Lobin0116/smart-glasses-charger/README.md

# smart-glasses-charger

AI Glasses Charging Case Firmware
