Lobin0116/smart-glasses-charger/CONTEXT.md

# Smart Glasses Charger — GD32E230C8T6 Firmware

## 项目背景

AI 眼镜充电盒固件，主控 GD32E230C8T6 (ARM Cortex-M23, LQFP48, 64KB Flash, 8KB SRAM)。
BLE 功能已移除，不实现任何蓝牙相关逻辑。

## 架构决策

- 运行模型: Bare-metal 超级循环 + 状态机（无 RTOS）
- 构建系统: CMake + arm-none-eabi-gcc（命令行构建）
- 外设库: GD32E23x 官方 Standard Peripheral Library V2.5.0
- 代码格式: clang-format 统一风格
- 交付: firmware/ 目录自包含，零 AI 痕迹

## 硬件平台

### MCU: GD32E230C8T6
- 12MHz 外部晶振 (PF0/PF1)
- 32.768K RTC晶振 (PC13/PC14/PC15)
- SWD调试: PA13(SWDIO) / PA14(SWCLK)

### 电源链路
- IP5353 (I2C_AABC): 移动电源SOC，Type-C PD/QC 18W输入，升压5V输出
- TPS563201: 12V降压
- RT9013-18: 1.8V LDO (PB10/1V8EN控制开关)
- 电池: 2000mAh 锂离子

### 无线充电
- MT5706: Qi2.0 EPP 15W (PB11/CHIP_EN2控制开关)

### I2C 总线 (PB6 SCL / PB7 SDA, I2C0, 200kHz)
- CW2017 电量计: 7-bit addr 0b1100011, 写=0xC6 读=0xC7
- IP5353: 控制寄存器 写=0xE8 读=0xE9, 状态寄存器 写=0xEA 读=0xEB

### POGO 通信链路
- ET3328 (SPDT模拟开关): POGO pin 5V充电 / 1.8V UART 切换
- BL1551B (U14): 半双工收发方向切换 (PB12/T/R_SWITCH)
- AiPTB0102TA8: 3.3V↔1.8V UART电平转换
- 物理层: 2-pin Pogo-Pin, UART 115200 8N1, 1.8V电平 (TIM 规格 921600，调试期偏离)

### ET3328 真值表 (MCU控制映射)
| 模式 | PB13(IN) | PB15(RPD) | PB10(1V8EN) | POGO状态 |
|---|---|---|---|---|
| 5V充电 | L | L | X | POGO↔CHG(5V) |
| 放电泄放 | X | H | H(1.8V on) | POGO放电 |
| 1.8V通信 | H | L | H(1.8V on) | POGO↔UART |

切换时序: 5V充电 → RPD=H放电100ms → IN=H切UART → 1V8EN=H开LDO → 通信

## 引脚分配表

| 引脚 | 信号 | 功能 | 外设 |
|---|---|---|---|
| PA0 | ADC_IN0 | 预留 | ADC |
| PA1 | ADC_IN1 | 预留 | ADC |
| PA2 | ADC_IN2 | 预留 | ADC |
| PA3 | ADC_IN3 | 预留 | ADC |
| PA4 | ADC_IN4 | 预留 | ADC |
| PA5 | ADC_IN5 | 预留 | ADC |
| PA6 | ADC_IN6 | 预留 | ADC |
| PA7 | ADC_IN7 | 预留 | ADC |
| PA8 | BAT_INT | 电量计中断 | GPIO输入(EXTI) |
| PA9 | CPU_TX | UART发送 | USART0_TX |
| PA10 | CPU_RX | UART接收 | USART0_RX |
| PA11 | CHAGER_INT | 有线充电中断 | GPIO输入(EXTI) |
| PA12 | COIL_INTB | 无线充电中断 | GPIO输入(EXTI) |
| PA13 | SWDIO | 调试 | SWD (禁占用) |
| PA14 | SWCLK | 调试 | SWD (禁占用) |
| PA15 | NC | 预留 | |
| PB0 | ADC_IN8 | 预留 | ADC |
| PB1 | ADC_IN9 | 预留 | ADC |
| PB2 | LED_2812 | WS2812数据 | GPIO输出 |
| PB3 | KEY | 按键(短按查电量) | GPIO输入(上拉) |
| PB4 | HALL_OUT_DIG | 霍尔磁场检测 | GPIO输入 |
| PB5 | NC | 预留 | |
| PB6 | SCL | I2C时钟 | I2C0_SCL (开漏) |
| PB7 | SDA | I2C数据 | I2C0_SDA (开漏) |
| PB8 | LEDR | 红色LED | GPIO输出 |
| PB9 | LEDG | 绿色LED | GPIO输出 |
| PB10 | 1V8EN | 1.8V LDO使能 | GPIO输出 |
| PB11 | CHIP_EN2 | 无线充电使能 | GPIO输出 |
| PB12 | T/R_SWITCH | 单线串口收发切换 | GPIO输出 |
| PB13 | POGO_IN | POGO通信使能(ET3328 IN) | GPIO输出 |
| PB14 | SHIP_CTR | 船运模式控制 | GPIO输出 |
| PB15 | RPD | POGO放电使能(ET3328 RPD) | GPIO输出 |
| PF0 | OSCIN | 12MHz晶振 | 固定保留 |
| PF1 | OSCOUT | 12MHz晶振 | 固定保留 |
| PF6 | LEDB | 蓝色LED | GPIO输出 |
| PF7 | LEDW | 白色LED | GPIO输出 |

## AT 通信协议

### 帧格式
Magic(4B) + CRC8(1B) + Size(2B) + Opcode(2B) + Status/Reserved(1B) + Payload(NB)
- 请求Magic: 0x23415423（小端线上字节 `23 54 41 23`）
- 响应Magic: 0x23415023（小端线上字节 `23 50 41 23`）
- CRC-8 使用协议文档提供的256字节查找表
- **CRC 覆盖范围（2026-09-04 真机修正）**：仅覆盖 **CRC 字节之后**的内容（Size/Opcode/Status/Payload），
  **不含 Magic**。协议 PDF 只给了查找表与 `at_crc8()` 函数、未写明覆盖范围；此前固件按"含 Magic"实现，
  与眼镜（MetaBounds 参考实现）互判 CRC 错误——真机握手死循环 `REQ → status=0x06 NAK`，HIL 未发现
  （PC 模拟器抄了固件同款算法）。真机抓包实证：眼镜 HEART RSP（0x25）与 NAK（0x52）按"不含 Magic"
  精确命中。修复见 main `99e1637` / V2 cherry-pick，`sgc_at.py` 同步（main `2f2fc7a`）。

**字节序（2026-08-14 统一）**：全部多字节字段（Magic/Size/Opcode 及 payload 内的 index/fw_size）统一**小端**；
`Size` 语义 = **payload 长度**（不含 10B 帧头），线上帧总长 = Size + 10。
此前实现为"帧头大端 + Size=总帧长 + OTA payload 小端"的混合格式，为对齐眼镜端协议（真机抓包确认
`23 54 41 23 · CRC · 04 00 · 01 30 · ...` 样式）已全量切换；PC 工具 sgc_at.py 同步。

### 指令集
| Opcode | 名称 | REQ Payload | RSP Payload |
|---|---|---|---|
| 0x3001 | 心跳包 | at_case_data | at_glass_data |
| 0x3002 | 关机/船运 | at_case_role | at_case_role |
| 0x3003 | 烧录准备 | at_case_role | at_case_packet_prepare |
| 0x3004 | 烧录数据 | at_case_packet_read | at_case_packet_transfer |

### 状态字段
- case_soc: bit7=1 充电中
- case_sta: bit0=开关盖(1开0关), bit7=申请OTA
- glass_soc: bit7=1 满电(0xE4=充满)
- glass_sta: bit7=1 同意

## 状态机设计

### 状态定义
- IDLE: 盖子关闭，无眼镜在盒，低功耗待机
- HANDSHAKING: 5V/300ms→0V/100ms泄放→1.8V发心跳(retry×3, 100ms间隔)
- CHARGING: 握手成功，供5V，30s(开盖)/60s(关盖)周期通信
- MAINTAINING: 握手成功但低电不充电，持续心跳维持入盒
- FORCE_CHARGING: 握手失败30s后，长供5V强充(3min/次, 持续9min)
- SHUTTING_DOWN: 充满/低电，发关机指令(retry×5)，然后休眠
- OTA: OTA传输流程
- SHIP_MODE: 船运模式

### 入盒检测机制
盒子发心跳 → 眼镜回复 = 入盒
盒子发心跳 → 无回复(retry 3次失败) = 不在盒/无法通信
眼镜端靠有无5V + 1.2s内心跳包维持或判断出盒

## 低功耗策略
- 正常休眠: Deep-Sleep，EXTI唤醒(霍尔/按键/CHAGER_INT/BAT_INT)，<50uA
- 船运模式: Standby + PB14(SHIP_CTR)外部控制，<5uA

## OTA 升级方案

布局（64KB flash @ 0x08000000, page = 1KB）：
- Bootloader: 0x08000000-0x08000FFF (4KB, page 0-3) — 永不擦，启动检查 + 搬运
- App slot A: 0x08001000-0x08007BFF (27KB, page 4-30) — 运行区
- Staging B: 0x08007C00-0x0800F7FF (31KB, page 31-61) — OTA 暂存区
- Meta: 0x0800F800 + 0x0800FC00 (page 62/63) — boot selector 双 page 轮换 (magic + staged + fw_size + seq + crc32)

流程：
1. App 收固件（眼镜推送，协议 0x3003/0x3004）→ 写 Staging B → 设 meta.staged → reset
2. BL 启动 → 读 meta → staged? → 擦 App pages + 复制 Staging→App + 清 staged → jump App
3. App 新版本运行

掉电安全：BL 永不擦自己，所有掉电场景都能恢复（Staging 完整时幂等搬运）。

关键约束：
- BL 跑 8MHz IRC（lite SystemInit 不配 PLL），搬运 ~3s
- BL 不开 WWDGT（reset 默认 off），App 自己 init
- BL jump App 前 `__enable_irq()`（App startup 不重新 enable）
- 单 image（眼镜推 App.bin 链接 ORIGIN=0x08001000），眼镜端零协议改动

构建产物：BL.hex + App.hex 合并为 combined.hex（`tools/merge_hex.py`），SWD 一次烧录。

详见 `docs/OTA_UPGRADE_PLAN.md`。

## LED 灯效规则
- 充电中(呼吸): 白(>40%) / 绿(15-40%) / 红(5-15%) / 红闪(1-5%)
- 充满: 白色长亮
- 查看电量(开盖/关盖): 对应颜色长亮7s灭
- 低电分级: >15%可充电可通信 / 5-15%可充电可通信 / 1-5%不可充电可开关 / <=0%关机

## IP5353 操作约束
- INT 持续为高 100ms 后才可读写 I2C 寄存器
- 修改寄存器需先读后改再写（read-modify-write），不可直接覆盖
- I2C 建议用 200kHz（最高 300kHz）

## NTC 温度保护分段阈值
- 0°C ~ <15°C: 0.2C / 4.45V
- 15°C ~ <45°C: 1.5C / 4.45V
- 45°C ~ 60°C: 0.5C / 4.1V
- 放电保护: -20°C ~ 60°C (TBD)

## 通信超时
- AT 协议请求→响应周期: **100ms**（spec，固件 OTA_TIMEOUT_MS=100）
- `at_frame_recv` 失败前清 buffer（避免 stale 干扰下次 retry）
- UART RX buffer: **512B**（容纳 2 个 OTA RSP，每个 255B；防止 HIL retry 时环形覆盖）

### OTA 稳定性历史（2026-08-12）
HIL 实测发现 OTA I02 在 100ms timeout 下 flaky。**根因不是 PC USB-TTL 抖动本身**，而是固件设计放大效应：
1. RX buffer 256B 装不下 2 个 RSP（510B），固件 retry 时 PC 第二个 RSP 环形覆盖第一个 → parse 失败 → 雪崩
2. at_frame_recv 失败时不清 buffer，stale 数据干扰下次 retry

**根本修复**：buffer 256B→512B + 失败前清 buffer。修复后 OTA_TIMEOUT_MS 保持 spec 100ms。

之前曾尝试 30ms timeout（实测有效但是治标），现已回退到 100ms。生产场景（眼镜 MCU 直连 POGO，<10ms 响应）不受影响。

## 低电阈值（待统一）
- 时序文档用电压: Vbat ≤ 3.4V = 低电
- 产品需求用 SOC%: ≤15% = 低电
- 3.4V 对应锂离子约 10-15% SOC，两文档不完全对齐
- 固件倾向以 CW2017 SOC% 为准，3.4V 作为后备判断

## LED 补充规则
- 眼镜&充电盒同时充满才显示白色
- 5min 无活动 → LED 关闭 → 进入休眠
- 低电关机前必须发 AT 关机指令给眼镜（适用所有低电休眠场景）

## 关键时序参数汇总
- 开盖/入盒握手: 5V/300ms → 0V/100ms泄放 → 1.8V心跳 retry×3(100ms间隔)
- 心跳维持入盒: <1.2s 间隔（眼镜端出盒检测超时）
- 开盖充电通信: 30s 周期
- 关盖充电通信: 60s 周期
- 强充: 30s握手失败后 → 长供5V, 3min/次, 持续9min
- 关机指令: retry×5, 无回复则认为已关机
- 充满后复充阈值: 眼镜电量 <98%
- LED电量显示: 长亮7s后灭

## 开发进度

状态: HIL 测试进行中（A 类协议测试 7/7 通过）
最新提交: HIL test hooks + USART RX DMA 通道修复 (2026-08-03)
Flash: 22056B / 64KB = 34.5%
RAM: 4424B / 8KB = 54.0%
源文件: 45 个 (.c + .h)
单元测试: 8 个，4 个测试套件，99 个 assertion，全部通过
HIL 测试: A 类协议 7/7 通过 (test_a_protocol.py，PC 模拟眼镜端)

| Task | 内容 | 状态 | Commit |
|---|---|---|---|
| 1 | 项目骨架 (SPL/CMSIS/CMake) | DONE | a91119f |
| 2 | HAL GPIO 初始化 | DONE | 95b7e67 |
| 3 | HAL USART0 (115200 半双工, DMA RX CH2 循环模式) | DONE | 0212d3c, 本次修复 |
| 4 | HAL I2C0 (200kHz) + 总线恢复 | DONE | c66cf7e, bfc1d2f |
| 5 | HAL EXTI (霍尔/按键/中断) | DONE | faa2f1c |
| 6 | HAL Timer (1ms tick) | DONE | 5c8c9b7 |
| 7 | HAL 电源切换 ET3328 | DONE | 41dacd3 |
| 8 | Driver CW2017 电量计 | DONE | 0e8eb9c |
| 9 | Driver IP5353 充放电 | DONE | d21b4e5 |
| 10 | Driver MT5706 无线充电 | DONE | a1cb320 |
| 11 | Driver LED | DONE | a1cb320 |
| 12 | Protocol at_types/at_crc | DONE | 55b184e |
| 13 | Protocol at_frame | DONE | 55b184e |
| 14 | Protocol at_opcode | DONE | 55b184e |
| 15 | App 状态机核心 | DONE | 6fcd38d |
| 16 | App 开盖流程 | DONE | 9359ef5 |
| 17 | App 关盖流程 | DONE | 9359ef5 |
| 18 | App OTA 流程 | DONE | daf3e2c |
| 19 | App LED 灯效 | DONE | 9359ef5 |
| 20 | App 低功耗管理 | DONE | de4249f |
| 21 | App 按键处理 | DONE | 9359ef5 |
| 22 | main.c 整合 | DONE | 89f93ae |
| 23 | 构建验证 | DONE | 89f93ae |
| 24 | App 眼镜入盒流程 | DONE | 9359ef5 |
| 25 | App NTC温度保护 | DONE | f36b374 |
| 26 | App 有线/无线充电仲裁 | DONE | f36b374 |
| 27 | App 复充逻辑 | DONE | f36b374 |
| 28 | App 开盖无眼镜分支 | DONE | 2ab35c7 |
| 29 | App LED并发优先级 | DONE | 9359ef5 |
| 30 | App 关盖无眼镜分支 | DONE | 2ab35c7 |
| 31 | 5min空闲超时 | CANCELLED (BLE相关) | |
| 32 | HAL 看门狗 IWDG | DONE | 6fcd38d |

集成修复历史:
- NTC温度保护/充电仲裁/复充/OTA调用/低电关机 — f36b374
- 关盖事件/无眼镜显示/Deep-Sleep/SOC刷新/按键动作 — 2ab35c7
- ISR竞争修复 (g_led_ctx deferred to main loop) — 6cc6574
- Deep-Sleep EXTI pending清除 + I2C总线恢复 — bfc1d2f
- USART RX DMA 通道修复 (CH1→CH2, 原 TX/RX 通道搞反) + 循环模式 ring buffer + update_mode peek (保留心跳响应字节不被命令解析消费) — 本次提交
- HIL 测试钩子 (sm_inject_lid_event / update_mode_poll OPEN/CLOSE/KEY/RESET) — 本次提交

测试套件:
| Suite | Assertions | 覆盖范围 |
|---|---|---|
| gpio_config | 24 | 引脚初始化/AF编号/LED电平/按键电平/使能控制 |
| protocol | 18 | CRC8/帧组装/帧解析/Magic校验/坏CRC拒绝/roundtrip |
| charge_flow | 38 | case_soc/sta字节构建/NTC分区/复充判断/充电仲裁 |
| state_machine | 19 | 全部状态转换路径/握手成功失败/低电关机/shutdown retry |

## 已知限制 (Known Limitations)

1. 阻塞调用: charge_flow 中握手序列阻塞约 800ms (5V 300ms + 泄放 100ms + retry 3×100ms)
   - 期间 LED 呼吸冻结、按键无响应
   - 看门狗超时 2s，不触发复位
   - 这是文档要求的物理时序，不可缩短
   - 如需消除卡顿可将 charge_flow 改为非阻塞状态机（代码量约翻倍）

2. OTA 阻塞: ota_run() 同步执行，期间主循环停滞
   - 内部每个 exchange 循环喂看门狗，不会复位
   - 传输时间取决于固件大小（921600 baud）

3. Deep-Sleep 时钟: SysTick 在 Deep-Sleep 期间停止
   - 唤醒后 hal_timer_get_ms() 时间不连续
   - 当前架构只在 ST_IDLE 时 sleep，握手/充电不经过 IDLE，不影响

## 待确认项 (Pending)

1. ~~LED方案: WS2812(PB2) vs 4路GPIO LED(PB8/PB9/PF6/PF7)~~
   - 已确认: 使用 4路 GPIO LED, 低电平点亮 (active-low)
   - WS2812(PB2) 不使用, hal 层 on/off 函数已按 active-low 实现

2. ~~A-SP1924RBGWW datasheet~~
   - 已确认: 输出低电平点亮 LED

## HIL 测试进展 (Hardware-in-the-Loop)

测试环境: GD32E230 核心板 + USB-TTL (PA9/PA10) + PC pytest 模拟眼镜端
测试矩阵: docs/HIL_TEST_MATRIX.md (9 类 ~70 用例)

最新 baseline (2026-08-12): 19 PASS / 1 XPASS / 2 flaky-PASS (A15/F03) / 1 FAIL (I01 retry-limit) / 3 skip / I02 偶发 PASS

| 类别 | 内容 | 状态 | 备注 |
|---|---|---|---|
| A | AT 协议帧格式 (Magic/Size/Opcode/CRC/Payload) | ✅ PASS 9/9 (含 A15 重写为 MAINTAINING 验证) | 2026-08-12；⚠ 2026-08-14 切换全小端+Size=payload长 后**未重跑**（用户指示），期望字节断言需更新 |
| B | 时序 (握手 800ms / 心跳间隔 / 30s 开盖 / 60s 关盖 / 9min 强充) | ✅ PASS B03/B04 | 2026-08-12 |
| C | 状态机转换全覆盖 | ✅ PASS C01/C02, C07 XPASS (xfail 标记可去) | C03/C12 skip（CW2017 profile 烧录后解锁，待硬件验证） |
| E | 按键 (短按查电量 / 50ms 去抖 / 长按忽略) | ✅ PASS E01 | 2026-08-12 |
| F | 霍尔 (双沿注入 / 开关盖转换) | ✅ PASS F01/F02/F03 (F02/F03 flaky 标记) | HIL 命令注入时序竞争 |
| G | LED 灯效 (呼吸颜色 / 充满白 / 查电量 7s / 低电红闪) | ❌ TODO | 需人眼观察或自动化 |
| H | 充电仲裁 (USB 优先 / 无线 fallback / NTC 停充) | ❌ TODO | — |
| I | OTA 升级 | ✅ PASS I01+I02（2026-08-14，全小端新协议下首测：I01 8s / I02 20.7s，烧录后心跳帧与眼镜真机抓包格式逐字节一致） | 旧大端时代的 flaky 已随 512B RX buffer + clear-on-failure 根治 |
| J | 低功耗 (Deep-Sleep <50uA / Standby <5uA / 唤醒源) | ❌ TODO | 需电流计 |

### I 类 OTA 已知问题（HIL 测试工具限制，非固件 bug）

**现象**：I02 完整 OTA 烧录过程中，固件 at_frame_recv 偶发 timeout (100-500ms)，
导致固件 retry，PC 端 [ota] 时序显示 `recv=213-1018ms`（正常 16ms）。
单次 rerun 烧录完成率约 70-90%，flaky reruns 后能 PASS。

**根因**（逻辑分析仪 + PC 详细时间戳定位）：
- PC pyserial write 函数本身快（w_call=11ms）
- PC flush 立刻完成（flush=0ms）
- **但 PC write 返回后到 PA10 实际输出字节之间偶尔延迟 200ms+**
- 延迟来自 Windows USB 调度 / USB-TTL 模块（CH340 等）内部缓冲
- 固件 at_frame_recv timeout 期间没收到 RSP，触发 retry

**关键结论**：**固件无 bug**。生产场景眼镜端 MCU 实时响应（< 10ms），
没有 USB-TTL 中间环节，不会出现此问题。

**已应用的缓解**：
- 固件 at_frame_recv 三个 wait 循环加 hal_wwdgt_feed（防 WDT 复位）
- at_frame_recv 成功消费后 hal_usart_rx_clear（清 stale 帧）
- OTA_TIMEOUT_MS=100ms, RETRIES=5（500ms 容错）
- ota_run fail_reason 诊断码 (10-18) + post-status fixture
- I01/I02 标 @pytest.mark.flaky(reruns=3)
- _enter_charging 改用 STATUS 验证（不依赖心跳间隔）

**未应用的进一步缓解**（如果 HIL 稳定性仍不够）：
1. PC 端关闭后台进程（VSCode/浏览器），任务管理器设 python.exe 优先级=高
2. 设备管理器 → USB Root Hub → 电源管理 → 取消"允许计算机关闭此设备以节约电源"
3. USB-TTL 直接接主板 USB 口（不通过 HUB）
4. 换 FTDI USB-TTL 模块（比 CH340 稳定）或 PCIe 串口卡（绕过 USB）
5. 固件 OTA_EXCHANGE_RETRIES 5 → 30（容错 3s，覆盖大部分抖动）

## 待硬件验证 (Hardware Verification Required)

以下功能已在软件层面实现和单元测试，但未在实际硬件上验证：

### 已通过 HIL 验证
- ✅ UART 实际通信 — POGO 心跳帧收发（A 类 9/9，2026-08-12）
- ✅ AT 协议帧格式（Magic/Size/Opcode/CRC/Payload）
- ✅ OTA 触发链路（I01：OTA 命令 → bit7 申请 → 同意 → PREPARE）
- ✅ OTA 完整烧录链路（I02 偶发 PASS：推 108 块 → BL 搬运 → 新版本运行 → 版本验证）
- ✅ 状态机基础转换（C01/C02/C07）
- ✅ 时序（B03 retry 间隔, B04 100ms 超时）
- ✅ 按键 + 霍尔（E01/F01/F02/F03）

### 待硬件验证（HIL 自动化）
1. **B 类时序** — 其余时序用例（30s/60s/9min 长周期）
2. **C 类状态机** — C03/C12 等 SOC 依赖 case（待 CW2017 profile 烧录后解锁）
3. **E 类按键** — 50ms 去抖 / 长按忽略（物理按键测试）
4. **F 类霍尔** — 物理磁铁触发（HIL 用命令注入已验证状态机逻辑）
5. **G 类 LED** — 呼吸效果 / 充满白长亮 / 查电量 7s / 低电红闪（G 类需人眼或光传感器自动化）
6. **H 类充电仲裁** — USB 插入切无线 / 拔 USB 切无线 / NTC critical 停充
7. **J 类低功耗** — Deep-Sleep <50uA / Standby <5uA / EXTI 唤醒源（HALL/KEY/CHAGER/BAT）

### 待硬件验证（非 HIL 自动化，需仪器/真机）
1. **I2C 实际通信** — CW2017/IP5353 寄存器读写（部分通过 SCAN 命令间接验证）
2. **电源时序** — ET3328 5V/0V/1.8V 切换波形（示波器抓 RPD/IN/1V8EN）
3. **充电全流程** — 开盖→握手→充电→充满→关机（真机 + 眼镜）
4. **OTA 与真眼镜端互通** — 协议一致性 + 实际升级成功率

### 已知硬件问题（阻塞部分测试）
- **~~CW2017 battery profile 未烧录~~**：**已在固件层实现 auto-burn**（cw2017.c：`cw2017_init` 启动时检查 MODE_CONFIG/SOC_ALERT/PROFILE，必要时自动烧录 80 字节 profile（⚠ Cellwise demo 默认的 4.2V 曲线，产品规格未定义截止电压，非电池厂数据）+ 触发 quickstart）。首次启动 ~250ms 烧录，后续启动 ~10ms 自检跳过。烧录后 VERSION=0xA0、SOC=0-100% 应正常，解锁 C03/C05/C12 等 SOC 依赖 case。**待硬件实测确认**（板子重新烧固件后自动生效）。

## 待完成 (Code/Documentation)

代码层尚未实现或待核对的项，按优先级排序：

| 项 | 说明 | 优先级 |
|---|---|---|
| SHIP_MODE 进入路径 | **待确认**：状态枚举 `ST_SHIP_MODE` 存在，`pm_enter_ship_mode()` 实现了（power_mgmt.c:32 → Standby + 拉高 PB14 SHIP_CTR），但代码无任何路径调用 → 当前是死代码。REQ §"运输功能"说"眼镜厂内设置进入船运模式"，但**进入触发机制不明**（工厂夹具？长按？HIL 命令？）。**决策暂缓**：暂留代码不动，待产品/工程确认进入方式后再删除死枚举或加触发路径 | 待确认 |
| ~~LED 低电红闪 7s（BATTERY_DISPLAY 低电分支）~~ | **已修复**：REQ §3 "1%<SOC≤5% 红闪 7s" 是查电量场景（不是持续低电闪）。`apply_effect(BATTERY_DISPLAY)` 低电分支改 LED_BLINK；`resolve_effect` 删 case_soc≤5% 自动闪路径；删 `LED_EFFECT_LOW_BATT_BLINK` 枚举。HIL 时人眼验证 | ✅ Done |
| ~~单元测试补 hal_bootmeta~~ | **已完成**：`firmware/tests/test_bootmeta.c` 12 用例 / 58 assertion 全通过。覆盖 pick_latest（空/m0/m1/双 seq 比较）+ meta_validate（bad magic/CRC）+ 双 page 轮换（set/clear 交替）+ 掉电恢复（一页 CRC 损坏时回退另一页）+ OTA round-trip。改动：hal_bootmeta.c 改用 `hal_flash_read` 取代直接 dereference（产代码 memory-mapped memcpy），让 host 测试可 mock；hal_flash.h/.c 加 `hal_flash_read` | ✅ Done |
| ~~SOC 异常兜底校验~~ + ~~CW2017 profile 烧录~~ | **已修复**：cw2017.c 启动时 auto-burn 80 字节 profile（⚠ Cellwise demo 默认 4.2V 曲线，未经电池规格证实），quickstart 后 SOC 应正常。`cw2017_get_soc` 保留 SOC==0/>100 fallback=100 兜底（防芯片异常）。C03/C05/C12 待硬件实测确认解锁 | ✅ Done |
| CW2017 profile 烧录工具 | 不需要独立工具：固件 cw2017_init 自检 + auto-burn 已实现，无需 HIL 命令/USB-I2C 适配器 | ✅ Done |
| 波特率发布前确认 | 当前 115200（调试期偏离 spec 921600），发布前与眼镜端对齐 | 发布前 |
| ota_verify 空函数 | 协议（PROT/TIM）无 checksum 字段，OTA_UPGRADE_PLAN §6 明确预留 | 低（协议扩展后补） |
| 5min 无活动 LED 关闭 | BLE 相关，已 CANCELLED（CONTEXT.md 已记录） | 取消 |

## ⚠️ 临时测试代码（HIL_TEST 编译开关隔离）

为兼顾"成品代码完整性"和"HIL 测试自动化"，所有测试钩子用 `HIL_TEST` CMake option + `#ifdef HIL_TEST` 编译开关隔离。**一份源码，两种构建**，无需手动还原代码。

### 构建方式

| 构建 | 命令 | 产物 | 用途 |
|---|---|---|---|
| **生产**（默认） | `cmake -S firmware -B build` | `build/smart_glasses_charger.hex` (21260B) | 成品固件，Deep-Sleep 生效，无测试接口 |
| **HIL 测试** | `cmake -DHIL_TEST=ON -S firmware -B build_hil` | `build_hil/smart_glasses_charger.hex` (25724B) + `build_hil/bootloader.hex` (2560B) + `combined.hex` (BL+App 合并) | 启用测试钩子，PC 自动驱动状态机 |

### 测试钩子清单（均由 `HIL_TEST` 宏控制）

| 钩子 | 位置 | HIL_TEST=ON 时 | HIL_TEST=OFF 时（生产） |
|---|---|---|---|
| ST_IDLE 保持唤醒 | `state_machine.c` `case ST_IDLE:` | `break;`（不 sleep） | `pm_enter_deep_sleep(); break;` |
| `sm_inject_lid_event` | `state_machine.c` + `.h` | 编译（供 OPEN/CLOSE 调用） | `#ifdef` 排除，不存在 |
| `update_mode` 模块 | `update_mode.c`（整文件）+ `.h` | 编译，提供 OPEN/CLOSE/KEY/RESET/STATUS/SCAN/I2C/OTA 命令（UPDATE 已删，OTA 替代） | `#ifdef` 排除，整文件为空 |
| `sm` 可见性 | `main.c` | `sm_ctx_t sm;`（非 static，供 update_mode extern） | `static sm_ctx_t sm;`（封装） |
| 主循环轮询 | `main.c` `while(1)` 开头 | 调用 `update_mode_poll()` | 不调用 |

### 设计原则

- **成品代码路径在 `#else` 分支清晰可见**：读代码即可看到生产行为（例如 `state_machine.c` 的 `case ST_IDLE:` 同时展示两种分支）
- **生产构建不包含测试代码**：`--gc-sections` + `#ifdef` 双保险，update_mode 模块在生产 hex 中完全不存在
- **无需手动还原**：切换构建配置即可，不会遗漏
- **测试 hex 与生产 hex 体积不同**（差 ~800B），便于区分

### 生产发布检查

- [ ] 发布 hex 来自 `build/`（HIL_TEST=OFF），不是 `build_hil/`
- [ ] `arm-none-eabi-size build/smart_glasses_charger.elf` 应为 ~21260B text（生产大小）
