Lobin0116/smart-glasses-charger/docs/spec/functional_analysis.docx

## 一、电源充放电核心链路（英集芯 IP5353）

### 核心芯片：IP5353 移动电源一体化 SOC

1. 输入路径（Type-C 充电盒自充）Type-C 接口先经过OVP/OCP 过压过流保护（耐压 28V，防高压插拔损坏），输出 3~4A/5V 给 IP5353。
  1. 支持 PD3.0/QC/FCP/AFC 全快充协议，最大 18W 输入给内置 2000mAh 锂电池充电，电池充电电流最高 4A，适配大电流快充。
  2. INT中断引脚直连 ATB1119G 主控，上报充电盒充放电状态。
2. 输出路径（给 AI 眼镜充电）IP5353 升压输出 5V，经过FT3328 模拟开关后给到 2-Pogo PIN 磁吸触点：
  1. 单线半双工通讯机制：当 VBUS_OUT 电压＞3.85V 时，供电与数据复用，实现充电同时读取眼镜电量、固件交互；
  2. TX/RX 串口直连 ATB1119G，完成眼镜与充电盒主控的数据互通。
3. 电池管理2000mAh 锂电池直接挂载 IP5353 电池端，内置过充 / 过放 / 过流 / 过温保护，大电流充放电自带散热控制。

## 二、无线充电支路（美芯晟 MT5706/MT5708）

- 功能：外部无线底座给充电盒无线补电，兼容 Qi2.0 EPP 15W 标准；
- 控制逻辑：线圈感应电压输入 MT5706，芯片EN使能脚由 ATB1119G 主控控制，可软件开关无线充电功能；
- 数据交互：MT5706 通过 I2C 总线上报无线充电功率、异常状态至 ATB1119G；
- 选型区分：MT5706 标准 15W，MT5708 高功率 36W，本方案穿戴设备优先 MT5706。

## 三、主控核心：ATB1119G（炬芯 BLE5.3 MCU）

### 芯片定位：整机大脑，集成蓝牙 5.3 低功耗 MCU

1. 核心能力
  - 超低功耗架构：BLE 待机电流仅 6μA，休眠 nA 级，满足充电盒 30 天以上静置待机；
  - 丰富外设：I2C、UART、多路 GPIO/PWM，统筹所有外设；
  - 蓝牙 5.3 BLE：与手机 APP 通讯，上报充电盒电量、眼镜电量、开盖状态。
2. 总线与外设对接
  - I2C 总线 1：对接库仑计 CW2217，读取电池精准剩余电量 SOC；
  - I2C 总线 2：对接无线充 MT5706，读取无线充电状态；
  - UART (TX/RX)：对接 FT3328 模拟开关，和 AI 眼镜单线通讯；
  - IO 控制 IP5353 使能、霍尔开盖检测；
  - PWM 驱动四色 RGBW 指示灯，显示充电 / 配对 / 低电状态；
  - GPIO 读取物理配对按键。

## 四、外设功能模块拆解

### 1. 电量检测：CW2217 高精度库仑计

赛微微电低功耗电量计，通过 I2C 上传电池电压、充放电电流、剩余电量百分比，相比单纯电压采样，电量误差＜3%，手机 APP 可精准显示剩余续航。

### 2. 开盖检测：SC2033 单极霍尔开关

盒盖内置磁铁，开盖 / 合盖时磁场变化触发 IO 电平变化，ATB1119G 识别后执行对应逻辑：

- 开盖：点亮指示灯、蓝牙广播连接手机、自动读取眼镜电量；
- 合盖：延时关闭指示灯、降低蓝牙发射功率，进入低功耗休眠。

### 3. 眼镜通讯：FT3328 模拟开关

实现充电供电 + 单线数据复用，5V 供电线路叠加半双工通讯信号，无需额外触点即可和 AI 眼镜交互固件、电量、设备配对信息。

### 4. 交互外设

- RGBW 四色 LED：PWM 驱动，多色区分状态（红 = 低电、橙 = 充电、绿 = 满电、蓝 = 蓝牙配对）；
- 物理按键：GPIO 输入，长按 3s 触发蓝牙配对，短按查询电量灯光提示。

## 五、整机工作流程梳理

1. 外部有线充电：Type-C 输入→OVP 保护→IP5353 给电池充电→ATB1119G 实时读取电量，LED 提示充电进度；
2. 外部无线充电：无线线圈→MT5706 接收→IP5353 给电池充电，主控同步监控无线功率；
3. 给 AI 眼镜充电：放入眼镜触发磁吸导通→IP5353 升压 5V→FT3328 输出至 Pogo PIN，同时单线读取眼镜数据；
4. 蓝牙交互：ATB1119G 通过 BLE5.3 连接手机 APP，同步充电盒 / 眼镜电量、开盖记录、固件升级；
5. 休眠节能：合盖后霍尔开关触发，主控降低蓝牙功耗，关闭 LED，整机进入微安级低功耗待机。

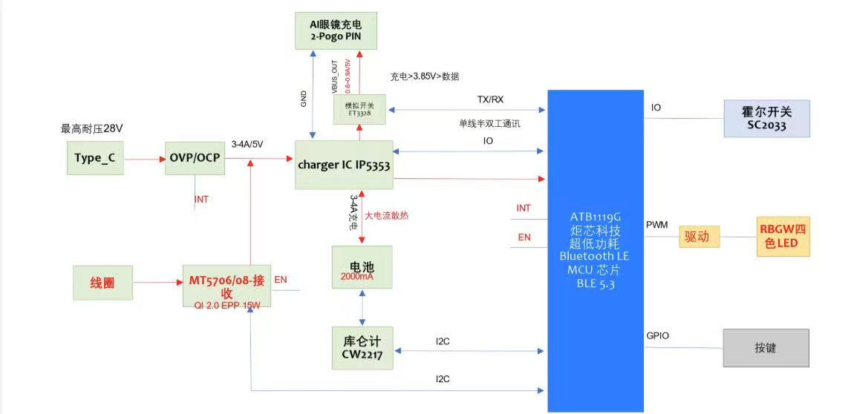
[picture p1: figure]
ddd81046b117e5e644b48d2da0b7e750
