Lobin0116/smart-glasses-charger/docs/spec/dual_pin_timing_v0.1.xlsx

Sheet: 首页
波特率：921600 校验位：无 数据位：8 停止位：1 通讯电平：1.8V，一个指令发送和等待回码共占时100ms
修改记录
日期 |  | 修改
2026-06-27 |  | 双pin机盒通信时序初版
Pin定义
Vbus/Uart |  | GND
5V切Vbus充电，1.8V切Uart 通信
机盒通讯指令
心跳包 |  |  |  |  |  |  |  |  |  |  |  | typedef struct { at_case_role role; // @see at_case_role_e uint8_t case_soc; uint8_t case_sta; } at_case_data; typedef struct { at_case_role role; // @see at_case_role_e uint8_t glass_soc; uint8_t glass_sta; uint8_t case_version; } at_glass_data;
请求帧 | MAGIC （4 Byte） | CRC （1 Byte） | SIZE (2 Byte) | OPCODE (2 Byte) | RESERVED (1 Byte) | PAYLOAD (N Byte)
 |  |  |  |  |  | at_case_data
 | 0x23415423 | crc |  | 0x3001 | 0x00 | 接收端（1 byte）： | 发送端（1 byte）： | 盒子电量（1byte）: 最高位为1表示充电 | 盒子状态（1byte）: bit0表示开关盖状态，1开盖，0关盖； bit7，1表示申请进入盒子ota； | NA
响应帧 | MAGIC （4 Byte） | CRC （1 Byte） | SIZE (2 Byte) | OPCODE (2 Byte) | STATUS (1 Byte) |  | PAYLOAD (N Byte)
 |  |  |  |  |  | at_glass_data
 | 0x23415023 | crc |  | 0x3001 | 0x00 | 接收端（1 byte）： | 发送端（1 byte）： | 眼镜电量（1byte）：最高位表示充满了，满电为0xE4; | 眼镜状态（1byte）： bit7:1 表示同意，0表示不同意 | 盒子固件版本（1byte）
关机/船运
请求帧 | MAGIC （4 Byte） | CRC （1 Byte） | SIZE (2 Byte) | OPCODE (2 Byte) | RESERVED (1 Byte) | PAYLOAD (N Byte)
 | 0x23415423 | crc |  | 0x3002 | 0x00 | 接收端（1 byte）： | 发送端（1 byte）：
响应帧 | MAGIC （4 Byte） | CRC （1 Byte） | SIZE (2 Byte) | OPCODE (2 Byte) | STATUS (1 Byte) | PAYLOAD (N Byte)
 | 0x23415023 | crc |  | 0x3002 | 0x00 | 接收端（1 byte）： | 发送端（1 byte）：
烧录准备(prepare) |  |  |  |  |  |  |  |  |  |  | typedef struct { at_case_role role; // @see at_case_role_e uint32_t size; } at_case_packet_prepare;
请求帧 | MAGIC （4 Byte） | CRC （1 Byte） | SIZE (2 Byte) | OPCODE (2 Byte) | RESERVED (1 Byte) | PAYLOAD (N Byte)
 |  |  |  |  |  | at_case_role
 | 0x23415423 | crc |  | 0x3003 | 0x00 | 接收端（1 byte）： | 发送端（1 byte）：
响应帧 | MAGIC （4 Byte） | CRC （1 Byte） | SIZE (2 Byte) | OPCODE (2 Byte) | STATUS (1 Byte) | PAYLOAD (N Byte)
 |  |  |  |  |  | at_case_packet_prepare
 | 0x23415023 | crc |  | 0x3003 | 0x00 | 接收端（1 byte）： | 发送端（1 byte）： | sizie：固件大小
烧录(read) |  |  |  |  |  |  |  |  |  |  | typedef struct { at_case_role role; // @see at_case_role uint16_t index; // 包序号 uint16_t size; // 包大小 } at_case_packet_read; typedef struct { at_case_role role; // @see at_case_role uint16_t index; // 包序号 uint8_t type; // @see at_packet_type_e uint8_t data[]; } at_case_packet_transfer;
请求帧 | MAGIC （4 Byte） | CRC （1 Byte） | SIZE (2 Byte) | OPCODE (2 Byte) | RESERVED (1 Byte) | PAYLOAD (N Byte)
 |  |  |  |  |  | at_case_packet_read
 | 0x23415423 | crc |  | 0x3004 | 0x00 | 接收端（1 byte）： | 发送端（1 byte）： | index：发包的计数 size
响应帧 | MAGIC （4 Byte） | CRC （1 Byte） | SIZE (2 Byte) | OPCODE (2 Byte) | STATUS (1 Byte) | PAYLOAD (N Byte)
 |  |  |  |  |  | at_case_packet_transfer
 | 0x23415023 | crc |  | 0x3004 | 0x00 | 接收端（1 byte）： | 发送端（1 byte）： | index； type； data；
眼镜端逻辑
出入盒 | 1.收到心跳包识别为入盒； 2.没有5v的时候进行1.2s出盒检测； 3.收到心跳包刷新1.2s出盒检测； 4.盒子ota过程中需要维持入盒状态；

Sheet: 开盖处理流程
1.开盖处理流程（盒子电量充足，包含盒子在充电）
1.1、开盖后输出5v 300ms让眼镜开机，再输出0v 100ms泄放，再切到1.8v 发心跳包；心跳包握手失败需retry 3次，每次间隔100ms；
1.2、心跳包里告知眼镜开关盖状态，同时获取到眼镜的电量及充电状态；
1.3、握手成功后，进入开盒充电，盒子供5v，每30s和眼镜通讯一次，通信时注意加100ms的泄放，收到眼镜充满后，不需要给眼镜发关机；// 这里眼镜端要注意双pin场景充电ic可能不会报截至
1.4、握手成功，眼镜充满后，盒子可不供5v，切1.8v通信，并不断给眼镜发心跳包（1.2s）内来维持眼镜的在盒状态，当眼镜电量低于98%的时候复充（需要显示电量的逻辑）； 或者可以继续按充电的逻辑保持5v，30s（可修改）通信一次，这样眼镜端可以维持在盒状态；
1.5、握手失败（retry 3次），继续 1.1 的操作，持续30s； 30s后，进入强充逻辑（考虑眼镜亏电的场景），长供5v，3分钟通信一次，持续9分钟； 强充之后如果眼镜依然没有回复，盒子进入休眠；如果眼镜正常回复走握手成功流程；
5V |  | 开盖波形 |  |  |  |  |  |  |  |  |  |  |  | 待完善
 |  | 5V
1.8V |  |  |  |  |  |  |  | 循环1 |  |  | 循环2
 |  |  |  | 心跳包 | 心跳包回复 |  |  | 心跳包 | 心跳包回复 |  | 心跳包 | 心跳包回复
GND
 |  |  | 500ms |  |  |  | 30s |  |  |  | 60s
 | 开盖握手成功
5V |  | 开盖波形 |  |  |  |  |  |  |  |  |  |  |  |  |  | 待完善
 |  | 5V
1.8V |  |  |  | 循环1（10s） |  |  |  |  | 循环2（3分钟）
 |  |  |  | 心跳包 |  | 心跳包 |  |  | 心跳包 |  |  | 心跳包
GND
 |  |  | 500ms |  | 间隔100ms |  | 间隔10s |  |  | 间隔10s |  |  |  | 盒子进入休眠
 | 开盖握手失败
2.开盖处理流程（盒子低电）
1.1、开盖后输出5v 300ms让眼镜开机，再输出0v 100ms泄放，再切到1.8v 发心跳包；心跳包握手失败需retry 3次，每次间隔100ms；
1.2、心跳包里告知眼镜开关盖状态，同时获取到眼镜的电量及充电状态；
1.3、握手成功后，不给眼镜充电，持续发心跳包（1.2s以内）以保持眼镜的在盒状态，直到盒子进入低电关机或休眠；
1.4、握手失败（retry 3次），直接进入休眠； // 失败直接进修改，按眼镜当前开机需要10~20s才能通信上的情况，低电开盖大概率都会走这里； 可以先这样，低电盒子开盖能激活眼镜就好了；
5V |  | 开盖波形 |  |  |  |  |  |  |  |  |  |  |  |  | 待完善
 |  | 5V
1.8V |  |  |  |  |  |  |  | 循环1 |  |  | 循环2
 |  |  |  | 心跳包 | 心跳包回复 |  |  | 心跳包 | 心跳包回复 |  | 心跳包 | 心跳包回复
GND |  |  |  |  |  |  |  |  |  |  |  |  | 盒子触发低电休眠
 |  |  | 500ms |  |  | 间隔10s |  |  |  | 间隔10s
 | 开盖握手成功
5V |  | 开盖波形 |  |  |  |  |  |  |  |  |  |  |  |  | 待完善
 |  | 5V
1.8V
 |  |  |  | 心跳包 |  | 心跳包 |  | 心跳包
GND
 |  |  | 500ms |  | retry 3次 |  |  |  | 盒子进入休眠
 | 开盖握手失败

Sheet: 开盒充电处理流程
1.盒子低电且不在充电，眼镜入盒
1.1、盒子检测眼镜入盒，具体方式由盒子端决定；
1.2、盒子检测到眼镜入盒，供5v 300ms让眼镜开机，再输出0v 100ms泄放，再切到1.8v 发心跳包； // 这里供5v300ms主要考虑到眼镜可能关机了，但是基本不会出现这个情况，后面具体情况具体分析
1.3、握手成功，不给眼镜充电，持续发心跳包（1.2s以内）以保持眼镜的在盒状态，直到盒子进入低电关机或休眠；
1.4、握手失败（retry 3次），直接进入休眠；// 这里可能需要持续，如果眼镜关机了，开机后需要10~20s才能通信上
5V |  | 眼镜入盒波形 |  |  |  |  |  |  |  |  |  |  |  |  | 待完善
 |  | 5V
1.8V |  |  |  |  |  |  |  | 循环1 |  |  | 循环2
 |  |  |  | 心跳包 | 心跳包回复 |  |  | 心跳包 | 心跳包回复 |  | 心跳包 | 心跳包回复
GND |  |  |  |  |  |  |  |  |  |  |  |  | 盒子触发低电休眠
 |  |  | 500ms |  |  | 间隔10s |  |  |  | 间隔10s
 | 眼镜入盒握手成功
5V |  | 眼镜入盒波形 |  |  |  |  |  |  |  |  |  |  |  |  | 待完善
 |  | 5V
1.8V
 |  |  |  | 心跳包 |  | 心跳包 |  | 心跳包
GND
 |  |  | 500ms |  | retry 3次 |  |  |  | 盒子进入休眠
 | 眼镜入盒握手失败
2.盒子电量充足（包含盒子在充电的场景），眼镜入盒
2.1、盒子检测眼镜入盒，具体方式由盒子端决定；
2.2、盒子检测到眼镜入盒，供5v 300ms让眼镜开机，再输出0v 100ms泄放，再切到1.8v 发心跳包；
2.3、握手成功后，进入开盒充电，盒子供5v，每30s和眼镜通讯一次，通信时注意加100ms的泄放，收到眼镜充满后，不需要给眼镜发关机；
2.4、握手失败（retry 3次），继续 2.2 的操作，持续30s； 30s后，进入强充逻辑（考虑眼镜亏电的场景），长供5v，3分钟通信一次，持续9分钟； 强充之后如果眼镜依然没有回复，盒子进入休眠；如果眼镜正常回复走握手成功流程；
5V |  | 眼镜入盒波形 |  |  |  |  |  |  |  |  |  |  |  | 待完善
 |  | 5V
1.8V |  |  |  |  |  |  |  | 循环1 |  |  | 循环2
 |  |  |  | 心跳包 | 心跳包回复 |  |  | 心跳包 | 心跳包回复 |  | 心跳包 | 心跳包回复
GND
 |  |  | 500ms |  |  |  | 30s |  |  |  | 60s
 | 眼镜入盒握手成功
5V |  | 眼镜入盒波形 |  |  |  |  |  |  |  |  |  |  |  |  |  | 待完善
 |  | 5V
1.8V |  |  |  | 循环1（10s） |  |  |  |  | 循环2（3分钟）
 |  |  |  | 心跳包 |  | 心跳包 |  |  | 心跳包 |  |  | 心跳包
GND
 |  |  | 500ms |  | 间隔100ms |  | 间隔10s |  |  | 间隔10s |  |  |  | 盒子进入休眠
 | 眼镜入盒握手失败

Sheet: 关盖处理流程
1.关盖处理流程(眼镜在盒，电池电压大于 3.4V(根据盒子实际情况))
1.1、盒子检测眼镜入盒，具体方式由盒子端决定；
1.2、盒子检测到眼镜入盒，供5v 300ms，再输出0v 100ms 泄放，再切到1.8v 发心跳包，走眼镜入盒充电流程；
1.3、盒子关盖，立刻发心跳包更新状态；
1.4、握手成功，进入关盒充电，每60s和眼镜通讯一次，收到眼镜充满信息后，给眼镜发关机指令（这里可以通过多次发关机指令来确认眼镜是否关机），然后进入休眠；
1.5、握手失败（retry 3次），进入强充逻辑（考虑眼镜亏电的场景），长供5v，3分钟通信一次，持续9分钟； 强充之后如果眼镜依然没有回复，盒子进入休眠；如果眼镜正常回复走关盒充电流程；
待完善
5V |  | 盒子关盖波形
 |  | 5V
1.8V |  |  |  |  |  |  |  | 循环1 |  |  | 循环2 |  |  | 收到眼镜充满标志位 |  |  | 发5次，当眼镜没有回复时认为眼镜已经关机，盒子进行休眠；5次后，盒子进入休眠；
 |  |  |  | 心跳包 | 心跳包回复 |  |  | 心跳包 | 心跳包回复 |  | 心跳包 | 心跳包回复 |  | 心跳包 | 心跳包回复 |  | 关机/船运 | 回复 | 关机/船运 | 回复 | 关机/船运
GND
 |  | 开盖状态 | 盒子关盖 |  |  |  | 进入关盖充电 |  |  |  | 心跳包间隔60s |  |  |  |  | 掉5v | 发关机/船运指令 |  |  |  | 盒子进入休眠
 | 盒子关盖握手成功
待完善
5V |  | 盒子关盖波形
 |  | 5V
1.8V |  |  |  |  |  |  |  | 循环2（3分钟）
 |  |  |  | 心跳包 | 心跳包 | 心跳包 |  | 心跳包 |  |  | 心跳包
GND
 |  | 开盖状态 | 盒子关盖 |  | retry 3次，间隔100ms |  |  | 间隔10s |  |  |  |  | 盒子进入休眠
 | 盒子关盖握手失败
2.关盖处理流程(电池电压小于等于 3.4V(根据盒子实际情况))
2.1、盒子检测眼镜入盒，具体方式由盒子端决定；
2.2、盒子检测到眼镜入盒，供5v 300ms，再输出0v 100ms 泄放，再切到1.8v 发心跳包，走眼镜入盒充电流程；
2.3、盒子关盖，立刻发心跳包更新状态；
2.4、握手成功，给眼镜发关机指令，然后进入休眠；
2.5、握手失败（retry 3次），直接进入休眠；
待完善
5V |  | 盒子关盖波形
 |  | 5V
1.8V |  |  |  |  |  |  | 发5次，当眼镜没有回复时认为眼镜已经关机，盒子进行休眠；5次后，盒子进入休眠；
 |  |  |  | 心跳包 | 心跳包回复 |  | 关机/船运 | 回复 |  | 关机/船运 | 回复 |  | 关机/船运
GND
 |  | 盒子低电关5v | 盒子关盖 |  |  |  |  |  |  |  |  |  | 盒子进入休眠
 | 盒子关盖握手成功
待完善
5V |  | 盒子关盖波形
 |  | 5V
1.8V
 |  |  |  | 心跳包 |  | 心跳包 |  | 心跳包
GND
 |  | 盒子低电关5v | 盒子关盖 |  | 间隔100ms |  |  | 盒子进入休眠
 | 盒子关盖握手成功

Sheet: 盒子ota流程
文字描述： 1.盒子申请进入ota，眼镜同意； 2.盒子发prepare指令，眼镜回复size； 3.盒子发read指令，包含包大小/index，眼镜端回复data/index/type； 4.直到烧录完成，盒子发心跳包清ota标志位（bit7），退出ota模式；
