Lobin0116/smart-glasses-charger/docs/spec/product_requirement_v0.1.xlsx

Sheet: 版本
版本号： Version NO. |  | V0.1
产品经理 Product Manager |  | 王贵明 |  |  | Date: | 2026.05.15
版本批准： Approval |  |  |  |  | Date:
修改记录Revision
版本号Version | Date | Name | Reason | Modifications Made |  | Changed
V 0.1 | 2026.05.15 | 王贵明 | 建档 | 初版

Sheet: 整机规格参数
产品规格描述
H/W | 细项 | Requirement | 备注
处理器
电池（Battery） | 类型 | 锂离子电池
 | 容量（mAh） | 2000mAh（TBD） | Target 6~8 times charging (TBD, need cost and ME design to refer)
 | 输入电流 | 2C充电 | 外界对眼镜盒充电
 | 输出电流 | 900mA MAX | 眼镜盒对眼镜充电
 | 典型给眼镜充电时间 | 80%电量，30min
无线充电 | 功率 | 15W
NTC | 充电保护 | 0℃ - <15℃：0.2C/4.45V 15℃ - < 45℃：1.5C/4.45V 45℃ - 60℃: 0.5C/4.1V | 分段保护(TBD)
 | 放电保护 | -20℃ - 60℃:XXC | TBD
传感器 (Sensor) | 霍尔传感器 | ✔YES □NO | 盒盖开合
 | 其他 | □YES ✔NO
按 键 （Keypad） | 功能键 | □YES ✔NO | 一个
接口 (I/O) | 眼镜盒充自身充电接口 | USB-C PD | 给充电盒充电
 | 眼镜充电接口 | 2-pin Pogo-Pin | 眼镜盒对眼镜充电
 | 其他接口 | □YES ✔NO
指示灯 | 指示灯 | ✔YES □NO | RGB灯一个
结 构（Mechanical） | 铰链 | 折叠设计
 | 三防功能 | / | 按键+type-c接口需要做防水设计 TBD
认证（Certification） | 船运模式 | ✔YES □ NO
 | 认证需求 | SRRC、FCC、CEC、CE、MIC、KIC、CCC | 中国、美国、日本、韩国、欧洲、中国台湾、泰国、新加坡、英国、阿联酋（以认证清单为准，和眼镜对齐）

Sheet: 眼镜盒交互定义
充电盒指示灯显示
Function Item | 触发条件 | 前置操作 | 指示灯状态 | 备注
1.外部电源对充电盒充电 | 1.插入USB | 充电盒未充电 | 1.充电盒电量＞40%，充电盒白色指示灯呼吸 2.15%≤盒电量≤40%：充电盒绿色指示灯呼吸 3.5%＜盒子电量≤15%，充电盒红色指示灯呼吸 4.1%＜盒子电量≤5%，充电盒红色指示灯呼吸 5、充满电，白色指示灯长亮。 | 1. 插入充电线，同时给充电盒和眼镜充电 2. 充电过程中，有其他动作切入，优先显示切入动作的灯效，后恢复充电灯效 3. 眼镜&充电盒同时充满才显示白色 | 仅供参考，实际UX有待客户明确
2.充电盒给眼镜充电 | 眼镜放入充电盒 |  | 1. 充电中，充电盒眼镜/对应指示灯呼吸（各级电量颜色） 2. 充满电，充电盒眼镜/对应指示灯亮7s（各级电量颜色），然后灭。 | 1. 充电盒电量低于5%，充电盒不给眼镜充电 2. 低电关机之前，发码给眼镜关机。
3.充电盒电量查看 | 1. 开盖或者关盖 | 充电盒未充电 | 1.充电盒电量＞40%，充电盒白色指示灯长亮7s，灭 2.15%≤盒电量≤40%：充电盒绿色指示灯长亮7s，灭 3.5%＜盒子电量≤15%，充电盒红色指示灯长亮7s，灭 4.1%＜盒子电量≤5%，红色灯闪烁7秒
4、低电状态说明 |  |  | 1. 盒子电量>15% ，对眼镜可充电可通信 2. 5%＜盒子电量≤15%，对眼镜可充电可通信 3. 1%＜盒子电量≤5%，不可充电，可以开关眼镜 4. 盒子电量≤0% 盒子，关机
Function Item | 触发条件 | 触发状态 | 指示灯状态 | 语音状态
2.运输功能 | 1. 眼镜厂内设置进入船运模式，超低功耗； 2. 取出眼镜，按(电源)键激活眼镜，激活后自动进入配对状态 3. 放入充电盒内. 对眼镜充电（即关盖-开盖一次），激活眼镜，激活后自动进入配对状态 | 运输模式 | N/A | N/A
充电盒开关盖功能 |  | 关盖：、眼镜关机；开盖：、眼镜开机
Function Item |  | 触发条件 | 前置操作 | 触发状态 | 备注
1. 开盒动作事件触发机制 | 1.1 无眼镜，盒子外指示灯显示盒子电量 | 打开充电盒盖 | 充电盒关闭 | 充电盒指示灯仅显示充电盒电量 | 1.充电盒电量＞40%，充电盒白色指示灯长亮7s，灭 2.15%≤盒电量≤40%：充电盒绿色指示灯长亮7s，灭 3.5%＜盒子电量≤15%，充电盒红色指示灯长亮7s，灭 4.1%＜盒子电量≤5%，红色灯闪烁7秒
 | 1.2 有眼镜，首次开盖（无连接记录） |  |  | 充电盒指示灯仅显示充电盒电量；7s 7s之后判断状态； 1、进入配对状态，白色每秒闪烁2次； 2、若眼镜/5min无连接，指示灯关闭； | 1.充电盒电量＞40%，充电盒白色指示灯长亮7s，灭 2.15%≤盒电量≤40%：充电盒绿色指示灯长亮7s，灭 3.5%＜盒子电量≤15%，充电盒红色指示灯长亮7s，灭 4.1%＜盒子电量≤5%，红色灯闪烁7秒
 | 1.3 有眼镜，有连接记录的情况下进入回连模式； |  |  | 充电盒指示灯仅显示充电盒电量；7s 7s之后判断状态； 1、如果15s后回连手机失败，进入配对状态，白色每秒闪烁2次； 2、若5min无连接眼镜/进入休眠，指示灯关闭； | 1.充电盒电量＞40%，充电盒白色指示灯长亮7s，灭 2.15%≤盒电量≤40%：充电盒绿色指示灯长亮7s，灭 3.5%＜盒子电量≤15%，充电盒红色指示灯长亮7s，灭 4.1%＜盒子电量≤5%，红色灯闪烁7秒
 | 1.4 有眼镜，长按充电盒功能键，按键时间=>8秒，重置眼镜（恢复出厂设置），眼镜进入配对模式； |  |  | 进入配对模式：充电盒白色指示灯1s闪2次； 连接成功（已连接模式）：指示灯白色长亮7s，熄灭； 若5min无连接眼镜/进入休眠，指示灯关闭；
Function Item |  | 触发条件 | 前置操作 | 触发状态 | 备注
2. 关盒动作事件触发机制 | 2.1 无眼/ | 关闭充电盒盖 | 充电盒开启 | 关闭充电盒盖，指示灯显示充电盒电量 | 1.充电盒电量＞40%，充电盒白色指示灯长亮7s，灭 2.15%≤盒电量≤40%：充电盒绿色指示灯长亮7s，灭 3.5%＜盒子电量≤15%，充电盒红色指示灯长亮7s，灭 4.1%＜盒子电量≤5%，红色灯闪烁7秒
 | 2.2 有眼镜 |  |  | 1、充电中，指示灯呼吸（颜色根据充电盒电量）。 2、充满电，指示灯长亮7s后灭 | 1.充电盒电量＞40%，充电盒白色 2.15%≤盒电量≤40%：充电盒绿色 3.盒子电量≤15%，充电盒红色
 | 眼镜连接APP，支持APP 显示眼镜盒电量指示
