Lobin0116/smart-glasses-charger/docs/spec/AT_Communication_Protocol.pdf

# AT 眼镜盒通信协议

## 1. 协议设计

## 1.1 帧格式

## AT 眼镜盒通信协议

[备注]

密级 | 内部公开

## 修订历史

版本 | 修订者 | 日期 | 备注
1.0 | 周泽煌 | 2026-01-21 | 初稿
1.1 | 戴杰 | 2026-03-21 | 增加机盒心跳/关机/ 盒子ota相关指令
1.2 | 戴杰 | 2026-03-26 | 调整ota相关指令逻 辑

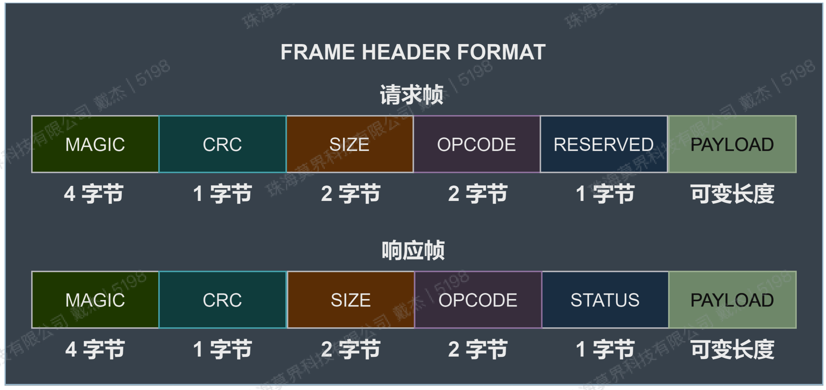
[picture p2: figure]

图 3-1 数据帧格式

### 2.1 字段说明

### 2.2 数据格式

字段 | 含义 | 长度 | 值 | 说明
Magic | 魔数 | 4 Bytes | 0x23415423 | 请求码（#AT#）
| | | 0x23415023 | 响应码（#AP#）
Crc | 校验码 | 1 Bytes | 0x00 ~ 0xFF | CRC-8校验码
Size | 负载大小 | 2 Bytes | 0x0000 ~ 0xFFFF
Opcode | 操作码 | 2 Bytes | 0x0000 ~ 0xFFFF | 指令 ID
Reserved | 保留字段 | 1 Bytes | 0x00 | 保留字段
Status | 状态码 | 1 Bytes | 0x00 | 成功
| | | 其它 | 失败
Payload | 数据负载 | 可变长度 | | 前两个字节用来区分数据流 向 参考at_case_role定义

## 2.2.1 Payload定义

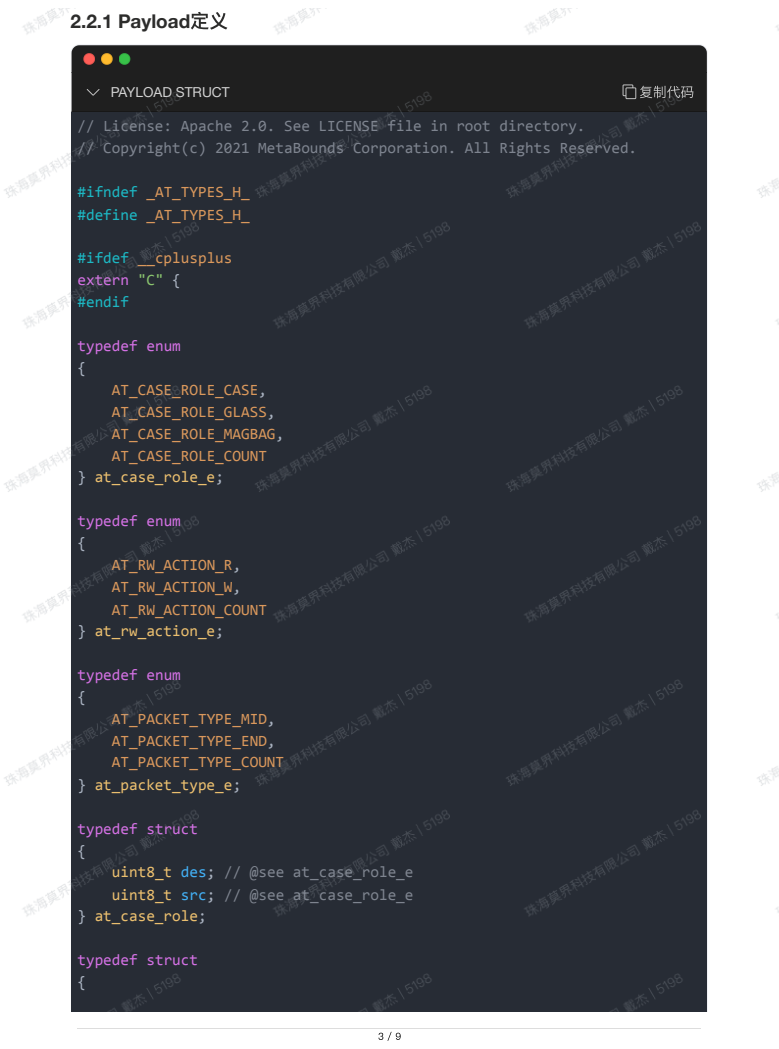
[picture p3: page 3]
PAYLOAD STRUCT; 复制代码; #ifndef _AT_TYPES_H_ #define _AT_TYPES_H_; #ifdef __cplusplus extern "C" { #endif; typedef enum {; AT_CASE_ROLE_CASE, AT_CASE_ROLE_GLASS, AT_CASE_ROLE_MAGBAG, AT_CASE_ROLE_COUNT } at_case_role_e;; AT_RW_ACTION_R, AT_RW_ACTION_W, AT_RW_ACTION_COUNT } at_rw_action_e;; AT_PACKET_TYPE_MID, AT_PACKET_TYPE_END, AT_PACKET_TYPE_COUNT } at_packet_type_e;; typedef struct {; uint8_t des; // @see at_case_role_e uint8_t src; // @see at_case_role_e } at_case_role;

// License: Apache 2.0. See LICENSE file in root directory.
// Copyright(c) 2021 MetaBounds Corporation. All Rights Reserved.

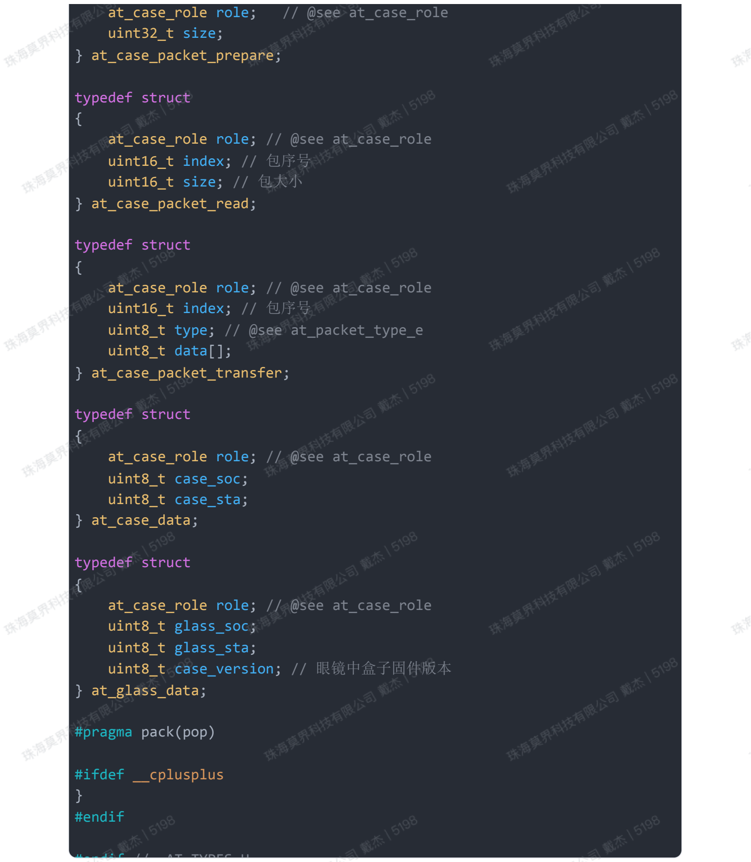
[picture p4: figure]
at_case_role role;; // @see at_case_role; uint32_t size; } at_case_packet_prepare;; typedef struct {; at_case_role role; // @see at_case_role uint16_t index; // 包序号 uint16_t size; // 包大小; } at_case_packet_read;; at_case_role role; // @see at_case_role uint16_t index; // 包序号; uint8_t type; // @see at_packet_type_e uint8_t data[]; } at_case_packet_transfer;; at_case_role role; // @see at_case_role uint8_t case_soc; uint8_t case_sta; } at_case_data;; at_case_role role; // @see at_case_role uint8_t glass_soc; uint8_t glass_sta; uint8_t case_version; // 眼镜中盒子固件版本; } at_glass_data;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

## 2.2.2 状态码

状态码枚举 | 复制代码

## typedef enum

{
AT_SUCCESS | = 0x00, // 成功
AT_ERR_IO | = 0x01, // IO 错误
AT_ERR_TIMEOUT | = 0x02, // 超时
AT_ERR_LENGTH | = 0x03, // 长度错误
AT_ERR_PARAMS | = 0x04, // 非法参数
AT_ERR_RESULT | = 0x05, // 测试失败
AT_ERR_CRC | = 0x06, // 校验错误
AT_ERR_CHANNEL | = 0x07, // 通道错误
AT_ERR_HARDWARE | = 0x08, // 硬件错误
AT_ERR_UNSUPPORT | = 0x09, // 不支持
AT_ERR_RUNTIME_MODE | = 0x0A, // 运行模式错误

## AT_ERR_DATA_NOT_READY = 0xFC, // 包不完整或不足以解析

AT_ERR_NULL | = 0xFD, // 空指针
AT_ERR_MAGIC | = 0xFE, // 魔数错误
AT_ERR_UNKNOEN | = 0xFF, // 未知错误
} at_status;
状态码 | 值 | 说明
AT_SUCCESS | 0x00 | 操作成功
AT_ERR_IO | 0x01 | IO 错误
AT_ERR_TIMEOUT | 0x02 | 响应、或执行超时
AT_ERR_LENGTH | 0x03 | 长度错误
AT_ERR_PARAMS | 0x04 | 非法参数
AT_ERR_RESULT | 0x05 | 指令执行失败
AT_ERR_CRC | 0x06 | CRC 校验错误
AT_ERR_CHANNEL | 0x07 | 通道传输错误
AT_ERR_HARDWARE | 0x08 | 硬件错误

## 2.3 指令集

## 2. 指令格式

# 3. CRC校验

at_crc.h | 复制代码

AT_ERR_UNSUPPORTED | 0xFE | 不支持
AT_ERR_UNKNOWN | 0xFF | 未知错误
操作码 | 值 | 说明
... | 0x3000 | ...
AT_OPCODE_CASE_HEART | 0x3001 | 机盒通信心跳
AT_OPCODE_CASE_SHUTDOWN | 0x3002 | 关机
AT_OPCODE_CASE_PACKET_PREPAR E | 0x3003 | 传输固件准备
AT_OPCODE_CASE_PACKET_READ | 0x3004 | 传输固件

#ifndef __AT_METAGLASS_CRC_H__ #define __AT_METAGLASS_CRC_H__

#include "mo_stdint.h"

#ifdef __cplusplus

extern "C" {
#endif

uint8_t at_crc8(uint8_t *ptr, uint16_t len, uint8_t crc_origin);

#ifdef __cplusplus

} /* extern "C" */
#endif

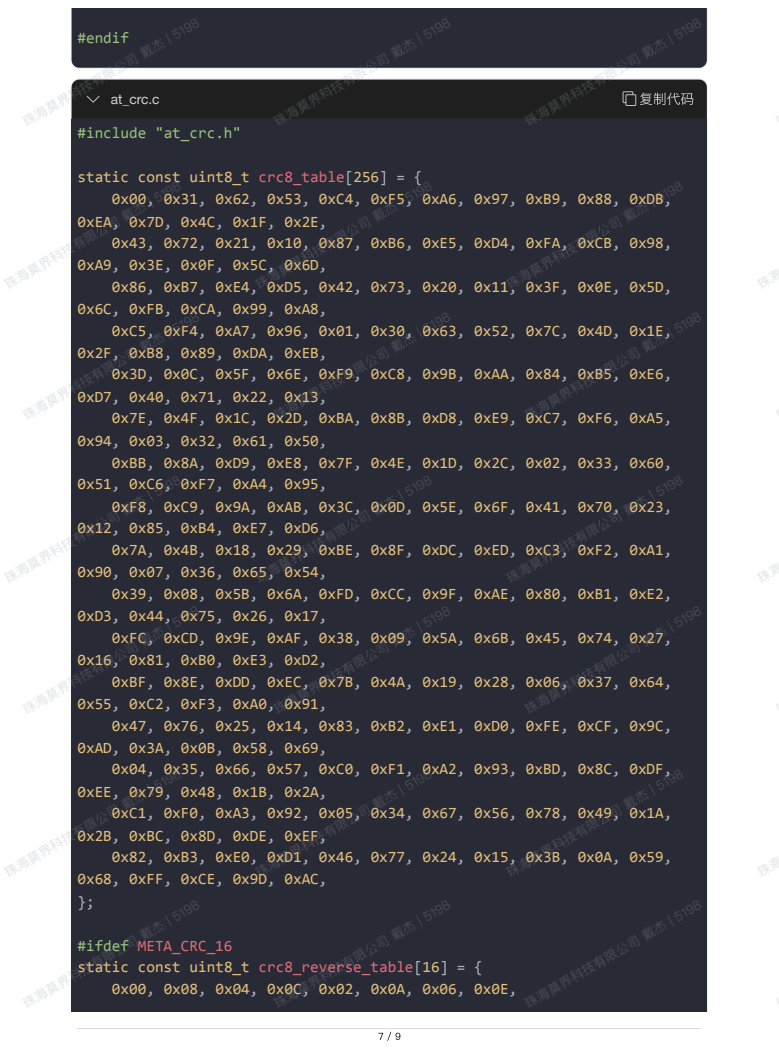
[picture p5: page 7]
at_crc.c; 复制代码; #endif; #include "at_crc.h"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

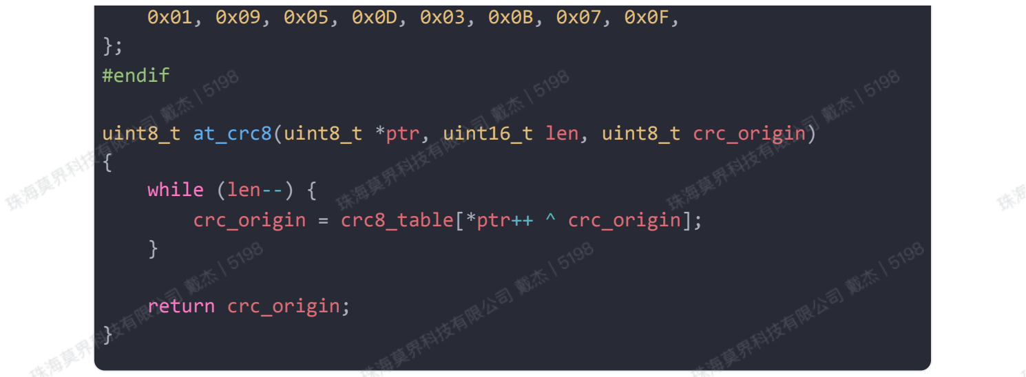
[picture p6: figure]
}; #endif; while (len--) { crc_origin = crc8_table[*ptr++ ^ crc_origin];; return crc_origin;

## 4. 指令格式

# 4.1 机盒心跳

# 4.2 关机

## 4.3 传输固件准备

0x01, 0x09, 0x05, 0x0D, 0x03, 0x0B, 0x07, 0x0F,

uint8_t at_crc8(uint8_t *ptr, uint16_t len, uint8_t crc_origin)

| Opcode | Payload
REQ | AT_OPCODE_CASE_HEA RT | at_case_data
RSP | | at_glass_data
| Opcode | Payload
REQ | AT_OPCODE_CASE_SH UTDOWN | at_case_role
RSP | | at_case_role
Opcode | Payload

# 4.4 传输固件

REQ | AT_OPCODE_CASE_PAC KET_PREPARE | at_case_role
RSP | | at_case_packet_prepare
| Opcode | Payload
REQ | AT_OPCODE_CASE_PAC KET_READ | at_case_packet_read
RSP | | at_case_packet_transfer
