Lobin0116/smart-glasses-charger/docs/schematic/GD32E230C8T6_pin_assignment.xlsx

Sheet: 引脚定义
引脚编号 | 引脚名称 | 引脚类型 | I/O电平 | 默认功能 (Default) | 复用功能 (Alternate) | 附加功能 (Additional) | 使用信号
1 | VDD | P |  | VDD PC13 TAMPER RTC |  |  | 3V3
2 | PC13/TAMPER/RTC | I/O |  | PC13 |  | RTC_TAMP0, RTC_TS, RTC_OUT, WKUP1 PC14
3 | PC14/OSC32IN | I/O |  | PC14 |  | OSC32IN PC15-
4 | PC15/OSC32OUT | I/O |  | PC15 |  | OSC32OUT
5 | PF0/OSCIN | I/O | 5VT | PF0 | I2C0_SDA | OSCIN PF1
6 | PF1/OSCOUT | I/O | 5VT | PF1 | I2C0_SCL | OSCOUT
7 | NRST | I/O |  | NRST
8 | VSSA | P |  | VSSA
9 | VDDA | P |  | VDDA
10 | PA0-WKUP | I/O |  | PA0 | USART0_CTS(3), USART1_CTS(4), CMP_OUT, I2C1_SCL(5) | ADC_IN0, CMP_IM6, RTC_TAMP1, WKUP0
11 | PA1 | I/O |  | PA1 | USART0_RTS(3), USART1_RTS(4), I2C1_SDA(5), EVENTOUT, TIMER14_CH0_ON(5) | ADC_IN1, CMP_IP
12 | PA2 | I/O |  | PA2 | USART0_TX(3), USART1_TX(4), TIMER14_CH0(5) | ADC_IN2, CMP_IM7
13 | PA3 | I/O |  | PA3 | USART0_RX(3), USART1_RX(4), TIMER14_CH1(5) | ADC_IN3
14 | PA4 | I/O |  | PA4 | SPI0_NSS, I2S0_WS, USART0_CK(3), USART1_CK(4), TIMER13_CH0, SPI1_NSS(5) | ADC_IN4, CMP_IM4
15 | PA5 | I/O |  | PA5 | SPI0_SCK, I2S0_CK | ADC_IN5, CMP_IM5
16 | PA6 | I/O |  | PA6 | SPI0_MISO, I2S0_MCK, TIMER2_CH0, TIMER0_BRKIN, TIMER15_CH0, EVENTOUT, CMP_OUT | ADC_IN6
17 | PA7 | I/O |  | PA7 | SPI0_MOSI, I2S0_SD, TIMER2_CH1, TIMER13_CH0, TIMER0_CH0_ON, TIMER16_CH0, EVENTOUT | ADC_IN7
18 | PB0 | I/O |  | PB0 | TIMER2_CH2, TIMER0_CH1_ON, USART1_RX(4), EVENTOUT | ADC_IN8
19 | PB1 | I/O |  | PB1 | TIMER2_CH3, TIMER13_CH0, TIMER0_CH2_ON, SPI1_SCK(5) | ADC_IN9
20 | PB2 | I/O | 5VT | PB2 | TIMER2_ETI
21 | PB10 | I/O | 5VT | PB10 | I2C0_SCL(3),I2C1_SCL(5), SPI1_IO2(5), SPI1_SCK(5)
22 | PB11 | I/O | 5VT | PB11 | I2C0_SDA(3),I2C1_SDA(5), EVENTOUT, SPI1_IO3(5)
23 | VSS | P |  | VSS
24 | VDD | P |  | VDD
25 | PB12 | I/O | 5VT | PB12 | SPI0_NSS(3), SPI1_NSS(5), TIMER0_BRKIN, I2C1_SMBA(5), EVENTOUT
26 | PB13 | I/O | 5VT | PB13 | SPI0_SCK(3), SPI1_SCK(5), TIMER0_CH0_ON, I2C1_TXFRAME(5), I2C1_SCL(5)
27 | PB14 | I/O | 5VT | PB14 | SPI0_MISO(3), SPI1_MISO(5), TIMER0_CH1_ON, TIMER14_CH0(5), I2C1_SDA(5)
28 | PB15 | I/O | 5VT | PB15 | SPI0_MOSI(3), SPI1_MOSI(5), TIMER0_CH2_ON, TIMER14_CH0_ON(5), TIMER14_CH1(5) | RTC_REFIN, WKUP6
29 | PA8 | I/O | 5VT | PA8 | USART0_CK, TIMER0_CH0, CK_OUT, USART1_TX(4), EVENTOUT
30 | PA9 | I/O | 5VT | PA9 | USART0_TX, TIMER0_CH1, TIMER14_BRKIN(5), I2C0_SCL, CK_OUT
31 | PA10 | I/O | 5VT | PA10 | USART0_RX, TIMER0_CH2, TIMER16_BRKIN, I2C0_SDA
32 | PA11 | I/O | 5VT | PA11 | USART0_CTS, TIMER0_CH3, CMP_OUT, EVENTOUT, SPI1_IO2(5), I2C0_SMBA, I2C1_SCL(5)
33 | PA12 | I/O | 5VT | PA12 | USART0_RTS, TIMER0_ETI, EVENTOUT, SPI1_IO3(5), I2C0_TXFRAME, I2C1_SDA(5)
34 | PA13 | I/O | 5VT | PA13 | SWDIO, IFRP_OUT, SPI1_MISO(5)
35 | PF6 | I/O | 5VT | PF6 | I2C0_SCL(3), I2C1_SCL(5)
36 | PF7 | I/O | 5VT | PF7 | I2C0_SDA(3), I2C1_SDA(5)
37 | PA14 | I/O | 5VT | PA14 | USART0_TX(3), USART1_TX(4), SWCLK, SPI1_MOSI(5)
38 | PA15 | I/O | 5VT | PA15 | SPI0_NSS, I2S0_WS, USART0_RX(3), USART1_RX(4), SPI1_NSS(5), EVENTOUT
39 | PB3 | I/O | 5VT | PB3 | SPI0_SCK, I2S0_CK, EVENTOUT
40 | PB4 | I/O | 5VT | PB4 | SPI0_MISO, I2S0_MCK, TIMER2_CH0, EVENTOUT, I2C0_TXFRAME, TIMER16_BRKIN
41 | PB5 | I/O | 5VT | PB5 | SPI0_MOSI,I2S0_SD, I2C0_SMBA, TIMER15_BRKIN, TIMER2_CH1 | WKUP5
42 | PB6 | I/O | 5VT | PB6 | I2C0_SCL, USART0_TX, TIMER15_CH0_ON
43 | PB7 | I/O | 5VT | PB7 | I2C0_SDA, USART0_RX,TIMER16_CH0_ON
44 | BOOT0 | I |  | BOOT0
45 | PB8 | I/O | 5VT | PB8 | I2C0_SCL, TIMER15_CH0
46 | PB9 | I/O | 5VT | PB9 | I2C0_SDA, IFRP_OUT, TIMER16_CH0, EVENTOUT, I2S0_MCK, SPI1_NSS(5)
47 | VSS | P |  | VSS
48 | VDD | P |  | VDD

Sheet: 完整引脚分配总表
引脚编号 | 引脚名 | 分配功能 |  | 复用资源 | IO 特性 | 方向 | 说明
1 | VDD | 电源 |  | / | 电源 | 电源 | 主供电
2 | PC13 | RTC | 晶振 | RTC_TAMP0 | I/O | 输入 | 32.768 晶振保留
3 | PC14 | OSC32IN |  | OSC32IN | I/O | 输入 | 32.768 晶振保留
4 | PC15 | OSC32OUT |  | OSC32OUT | I/O | 输出 | 32.768 晶振保留
5 | PF0 | OSCIN | 高速晶振 | / | 5VT I/O | 输入 | 12MHz 外部晶振，保留
6 | PF1 | OSCOUT | 高速晶振 | / | 5VT I/O | 输出 | 12MHz 外部晶振，保留
7 | NRST | 复位脚 |  | / | I/O | 输入 | 系统复位
8 | VSSA | 模拟地 |  | / | 电源 | 电源 | 模拟电源地
9 | VDDA | 模拟电源 |  | / | 电源 | 电源 | 模拟供电
10 | PA0 | ADC | 预留 | ADC_IN0 | I/O | 预留 | ADC 备用通道 0
11 | PA1 | ADC | 预留 | ADC_IN1 | I/O | 预留 | ADC 备用通道 1
12 | PA2 | ADC | 预留 | ADC_IN2 | I/O | 预留 | ADC 备用通道 2
13 | PA3 | ADC | 预留 | ADC_IN3 | I/O | 预留 | ADC 备用通道 3
14 | PA4 | ADC | 预留 | ADC_IN4 | I/O | 预留 | ADC 备用通道 4
15 | PA5 | ADC | 预留 | ADC_IN5 | I/O | 预留 | ADC 备用通道 5
16 | PA6 | ADC | 预留 | ADC_IN6 | I/O | 预留 | ADC 备用通道 6
17 | PA7 | ADC | 预留 | ADC_IN7 | I/O | 预留 | ADC 备用通道 7
18 | PB0 | ADC | 预留 | ADC_IN8 | I/O | 预留 | ADC 备用通道 8
19 | PB1 | ADC | 预留 | ADC_IN9 | I/O | 预留 | ADC 备用通道 9
20 | PB2 | LED_2812 | WS2812数据 | 普通 GPIO | 5VT I/O | 输出 | 单总线彩灯控制
21 | PB10 | 1V8EN | 1.8V电源使能 | 普通 GPIO | 5VT I/O | 输出 | 1.8V LDO 开关控制
22 | PB11 | CHIP_EN2 | 无线充电使能 | 普通 GPIO | 5VT I/O | 输出 | 无线充芯片电源使能
23 | VSS | 数字地 |  | / | 电源 | 电源 | 数字地
24 | VDD | 主电源 |  | / | 电源 | 电源 | 主供电
25 | PB12 | T/R_SWITCH | 单线串口切换 | 普通 GPIO | 5VT I/O | 输出 | 半双工收发切换控制脚
26 | PB13 | POGO_IN | POGO通信使能 | 普通 GPIO | 5VT I/O | 输出 | POGO 探针芯片使能
27 | PB14 | SHIP_CTR | 船运模式 | 普通 GPIO | 5VT I/O | 输出 | 低功耗船运控制
28 | PB15 | RPD | POGO放电使能 | 普通 GPIO | 5VT I/O | 输出 | POGO 总线放电开关
29 | PA8 | BAT_INT | 电量计中断 | 普通 GPIO | 5VT I/O | 输入 | 外部中断，电量告警
30 | PA9 | CPU_TX | UART发送 | USART0_TX | 5VT I/O | 输出 | 硬件串口发送
31 | PA10 | CPU_RX | UART接收 | USART0_RX | 5VT I/O | 输入 | 硬件串口接收
32 | PA11 | CHAGER_INT | 有线充电中断 | 普通 GPIO | 5VT I/O | 输入 | 外部中断，充电状态上报
33 | PA12 | COIL_INTB | 无线充电中断 | 普通 GPIO | 5VT I/O | 输入 | 外部中断，无线充中断
34 | PA13 | SWDIO | 下载数据 | SWDIO | 5VT I/O | 复用 | 调试下载，禁止占用功能
35 | PF6 | LEDB | 蓝色LED | 普通 GPIO | 5VT I/O | 输出 | LED 推挽输出
36 | PF7 | LEDW | 白色LED | 普通 GPIO | 5VT I/O | 输出 | LED 推挽输出
37 | PA14 | SWCLK | 下载时钟 | SWCLK | 5VT I/O | 复用 | 调试下载，禁止占用功能
38 | PA15 | 预留 | NC | / | 5VT I/O | 预留 | 备用 IO
39 | PB3 | KEY | 按键输入 | 普通 GPIO | 5VT I/O | 输入 | 上拉输入，按键检测
40 | PB4 | HALL_OUT_DIG | 霍尔输入 | 普通 GPIO | 5VT I/O | 输入 | 霍尔磁场检测输入
41 | PB5 | 预留 | NC | / | 5VT I/O | 预留 | 备用 IO
42 | PB6 | SCL | I2C总线时钟 | I2C0_SCL | 5VT I/O | 开漏输出 | 硬件 I2C 时钟
43 | PB7 | SDA | I2C总线数据 | I2C0_SDA | 5VT I/O | 开漏输出 | 硬件 I2C 数据
44 | BOOT0 | 启动选择脚 |  | / | 输入 | 输入 | 上电启动模式配置
45 | PB8 | LEDR | 红色LED | 普通 GPIO | 5VT I/O | 输出 | LED 推挽输出
46 | PB9 | LEDG | 绿色LED | 普通 GPIO | 5VT I/O | 输出 | LED 推挽输出
47 | VSS | 数字地 |  | / | 电源 | 电源 | 数字地
48 | VDD | 主电源 |  | / | 电源 | 电源 | 主供电
二、分配逻辑说明
1. ADC 通道全部预留（核心调整）
PA0~PA7（8 路）+ PB0、PB1（2 路），共 10 路 ADC 全部不分配数字功能，完整预留做模拟采集备用，后续接电压检测、温度、电池电压等模拟信号可直接使用，无需改引脚。
2. I2C 总线（SCL/SDA）
选用 PB6(I2C0_SCL)、PB7(I2C0_SDA) 硬件 I2C0，5V 容忍 IO，开漏模式，外接 4.7K 上拉即可标准 I2C 通信，适配电量计、充电芯片等多数外设。
3. UART 串口（CPU_TX/RX + T/R_SWITCH）
PA9(USART0_TX)、PA10(USART0_RX) 硬件串口做通信主通道，5V 容忍，电平兼容更宽；
PB12 配置普通 GPIO 做半双工切换脚 T/R_SWITCH，控制单线串口收发方向切换。
4. 中断输入（全部分配可外部中断的 5V 容忍 IO）
PA8：BAT_INT 电量计中断
PA11：CHAGER_INT 有线充电中断
PA12：COIL_INTB 无线充电中断
三路均支持下降沿 / 上升沿外部中断，上拉输入，充电、电量异常可实时唤醒 MCU。
5. 输入检测
PB3：KEY 物理按键输入，内部上拉，支持按键中断唤醒；
PB4：HALL_OUT_DIG 霍尔传感器数字输入，检测开合盖 / 磁场状态。
6. 电源 / 芯片使能输出（全部 5V 容忍推挽输出）
PB10：1V8EN 1.8V 电源轨使能
PB11：CHIP_EN2 无线充电芯片电源使能
PB13：POGO_IN POGO 探针芯片通信使能
PB14：SHIP_CTR 船运低功耗模式控制
PB15：RPD POGO 总线放电通路使能
7. LED 指示灯
PB8：LEDR 红色 LED
PB9：LEDG 绿色 LED
PF6：LEDB 蓝色 LED
PF7：LEDW 白色 LED
PB2：LED_2812 单线 WS2812 彩灯控制，5V 容忍直接驱动
8. 固定保留引脚（不可复用功能）
1. PC13/PC14/PC15：32.768K RTC 低速晶振
2. PF0/PF1：12MHz 高速外部晶振
3. PA13 (SWDIO)/PA14 (SWCLK)：SWD 程序下载调试口（烧录必备，禁止占用）
4. NRST 复位脚、BOOT0 启动脚、所有 VDD/VSS/VDDA/VSSA 电源引脚固定不动
9. 剩余备用 IO
PA15、PB5，共 2 路普通 5V 容忍 IO 预留，后续新增功能可直接扩展。
三、剩余备用 IO（可扩展新增功能）
PB15、PA12、PF6、PF7、PA15、PB3、PB4、PB5、PB6、PB7、PB8、PB9
预留充足 IO，后期新增传感器、指示灯、外设可直接使用。
四、硬件设计建议
1. I2C PB10/PB11 外部增加 4.7K 上拉电阻到 VDD；
2. 所有中断输入、按键、霍尔输入开启 MCU 内部上拉；
3. LED 驱动串联 220Ω 限流电阻；
4. WS2812 PB2 走线尽量短，必要串联 33Ω 电阻防信号反射；
5. 12M 晶振 PF0/PF1 匹配 33pF 负载电容；32.768K PC14/15 匹配 6~12pF 电容；
6. SWD PA13/PA14 预留焊盘，方便烧录调试，不外接负载。
