Lobin0116/smart-glasses-charger/docs/schematic/SCH_Schematic1_2026-08-04.pdf

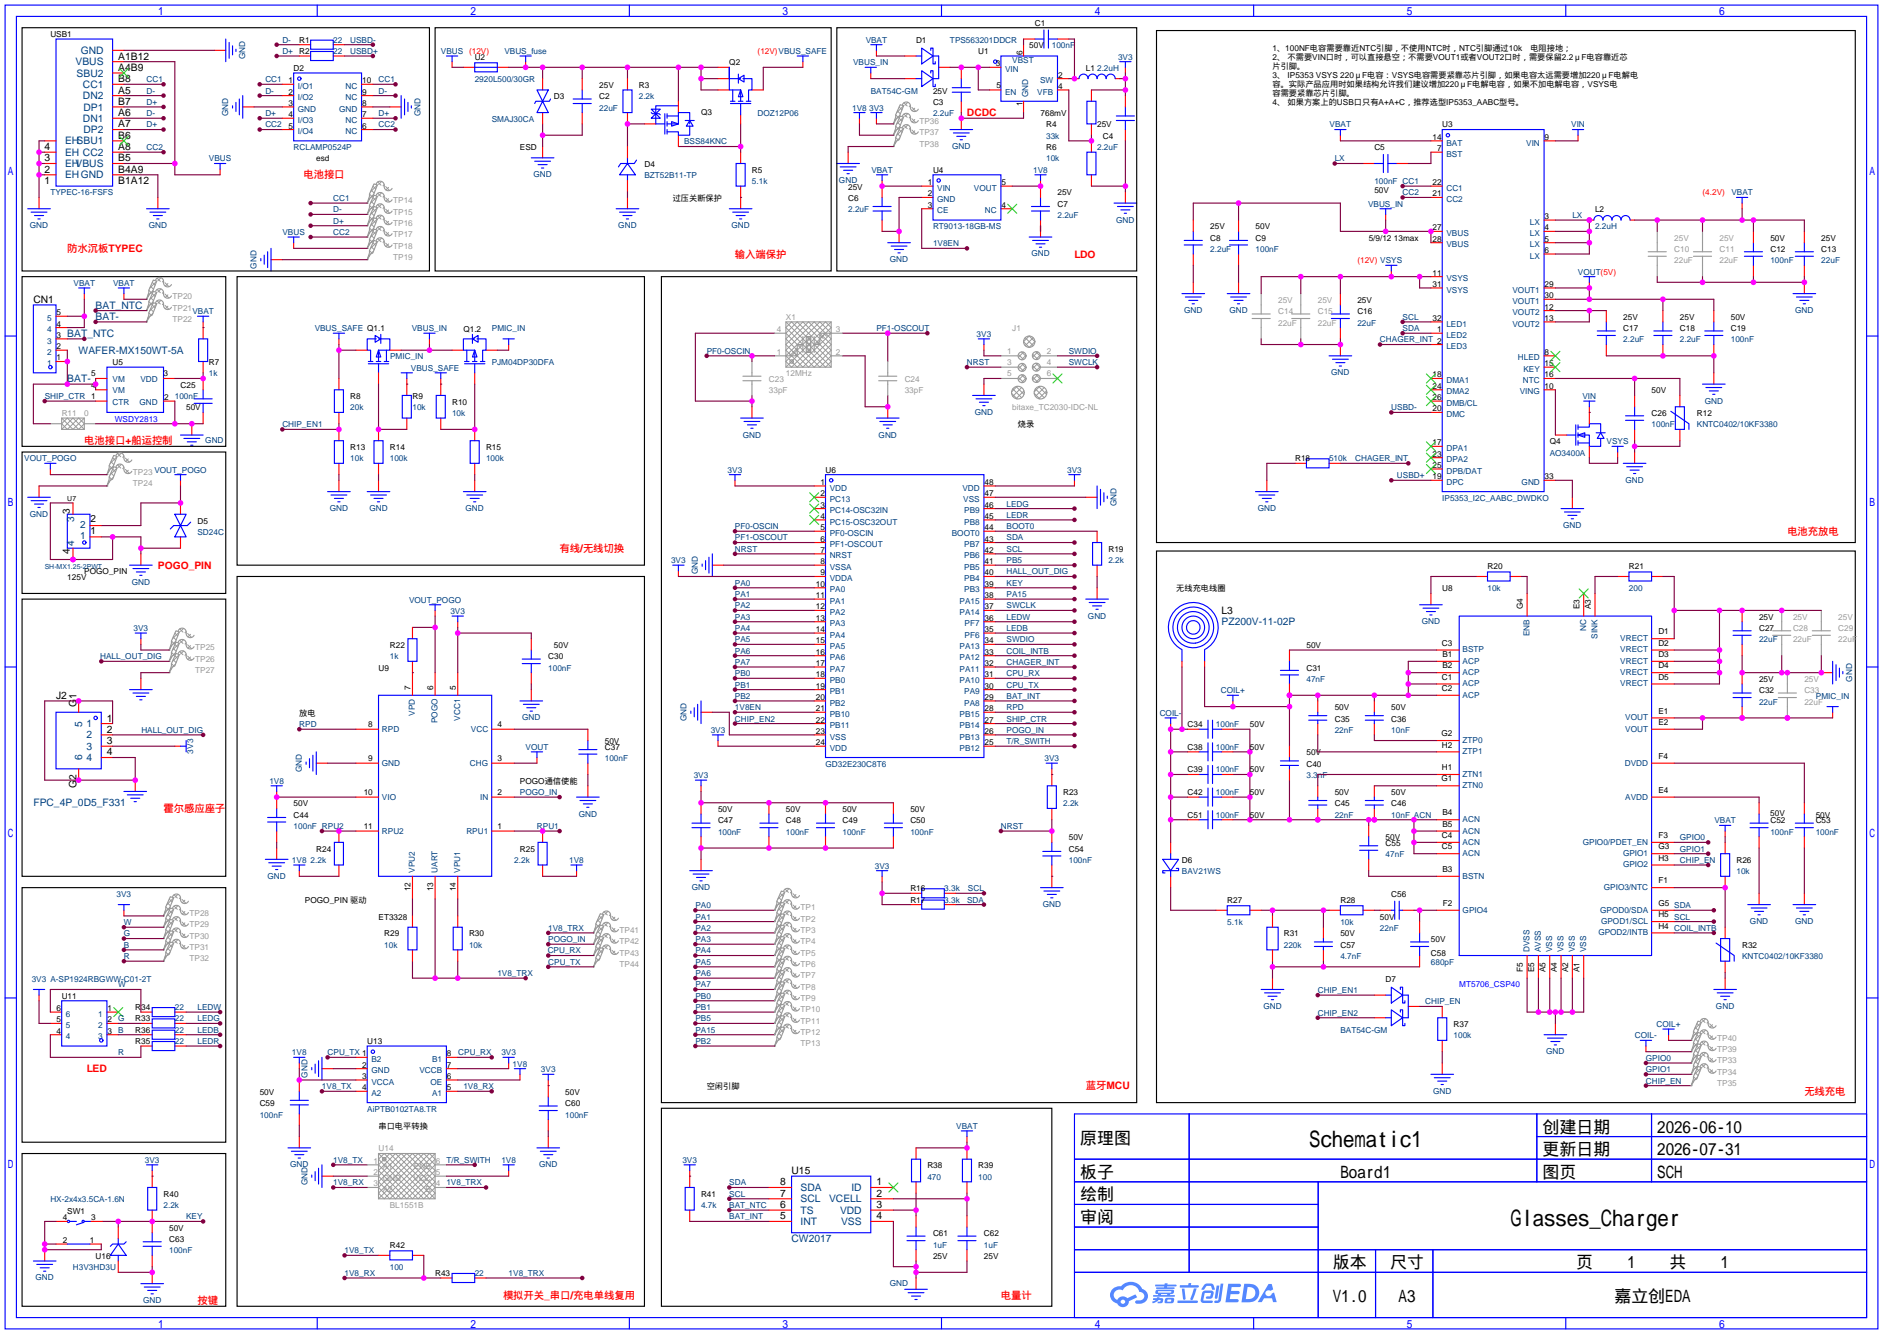
[picture p7: page 1]

USB1
GND A1B12 VBUS A4B9 SBU2 B8 CC1 A5 DN2 B7 DP1 A6 DN1 A7 DP2 B6 SBU1 A8 CC2 B5 VBUS B4A9 GND B1A12

1、100NF电容需要靠近NTC引脚，不使用NTC时，NTC引脚通过10kΩ电阻接地；
2、 不需要VIN口时，可以直接悬空；不需要VOUT1或者VOUT2口时，需要保留2.2 F电容靠近芯
片引脚。
3、 IP5353 VSYS 220 F电容：VSYS电容需要紧靠芯片引脚，如果电容太远需要增加220 F电解电
容。实际产品应用时如果结构允许我们建议增加220 F电解电容，如果不加电解电容，VSYS电
容需要紧靠芯片引脚。
4、 如果方案上的USB口只有A+A+C，推荐选型IP5353_AABC型号。

VING 10 NTC 16 KEY 15 HLED 8

原理图 | Schematic1 | 创建日期 | 2026-06-10

更新日期 | 2026-07-31

板子 | Board1 | 图页 | SCH
绘制 | | Glasses_Charger
审阅

V1.0 | A3 | 嘉立创EDA
