Lobin0116/smart-glasses-charger/docs/schematic/SCH_Schematic1_2026-07-10.pdf

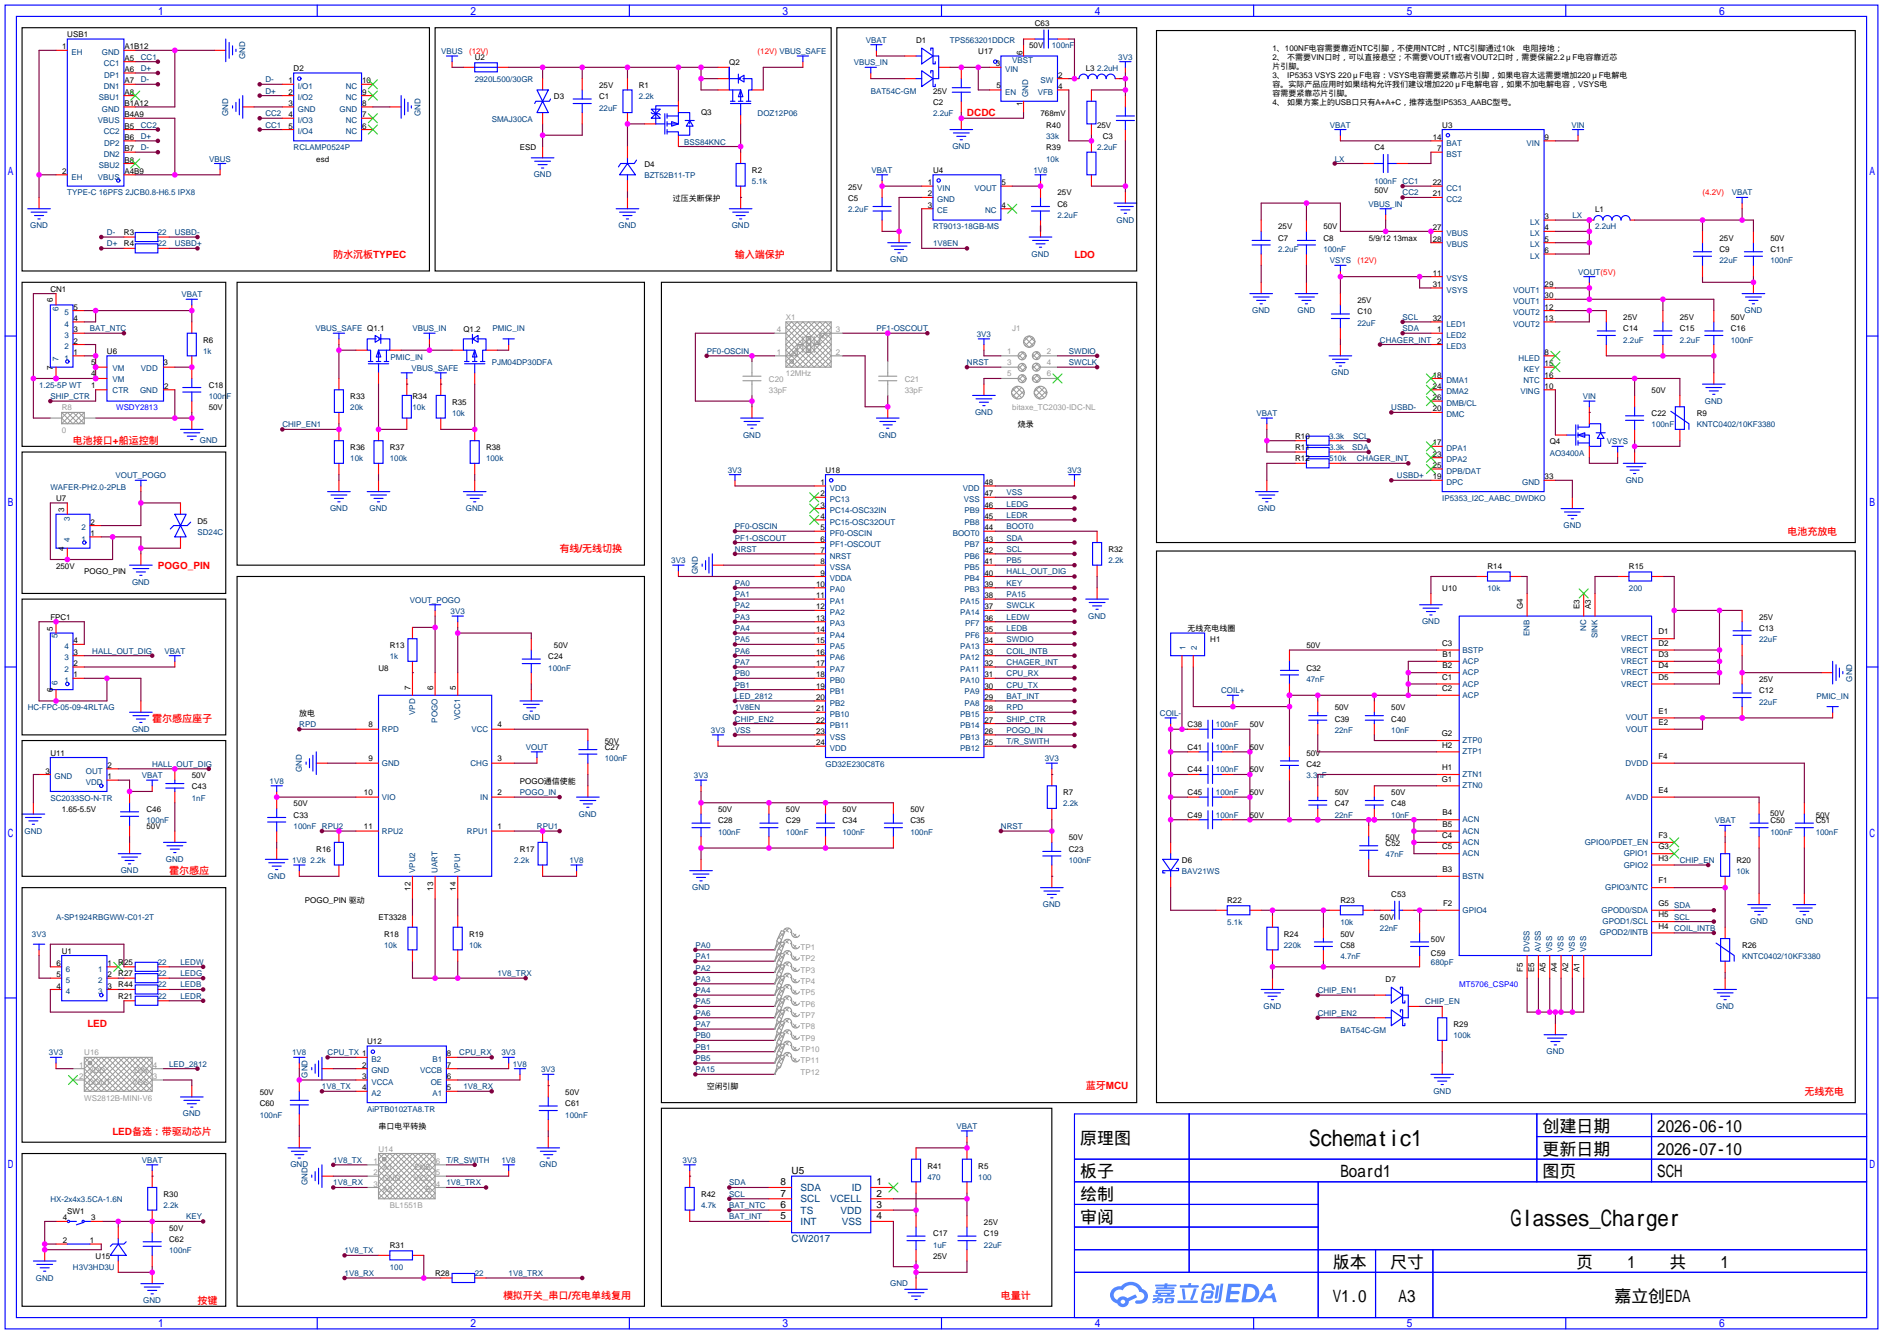
[picture p8: page 1]

USB1
VBUS A4B9 SBU2 B8 DN2 B7 DP2 B6 CC2 B5 VBUS B4A9 GND B1A12 SBU1 A8 DN1 A7 DP1 A6 CC1 A5 GND A1B12 EH 1

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

原理图 | Schematic1 | 创建日期 | 2026-06-10

更新日期 | 2026-07-10

板子 | Board1 | 图页 | SCH
绘制 | | Glasses_Charger
审阅

V1.0 | A3 | 嘉立创EDA
