Lobin0116/smart-glasses-charger/firmware/src/app/ota_flow.c

#include <stddef.h>
#include <string.h>

#include "ota_flow.h"

#include "at_frame.h"
#include "at_opcode.h"
#include "at_types.h"
#include "gd32e23x.h"
#include "hal_bootmeta.h"
#include "hal_flash.h"
#include "hal_timer.h"
#include "hal_usart.h"
#include "hal_wwdgt.h"

/* Timing budget from CONTEXT.md "通信超时": the AT request-response cycle is
 * 100 ms. The HIL bed's USB-TTL jitter used to force this down to 30 ms, but
 * the real fix (larger RX buffer + clearing stale data on parse failure) lets
 * us keep the spec value. */
#define OTA_TIMEOUT_MS 100U

/* Heartbeats sent while waiting for the glasses to agree, spaced one cycle apart
 * so the case keeps holding the glass in-box during the wait. */
#define OTA_REQUEST_RETRIES 3U
#define OTA_REQUEST_GAP_MS  100U

/* Bounded retries for the prepare and per-block exchanges. */
#define OTA_EXCHANGE_RETRIES 5U

/* Data bytes pulled per read request. The response carries a 5-byte header
 * (role + index + type) ahead of the data, so 240 keeps the response payload
 * under AT_FRAME_MAX_PAYLOAD with margin. */
#define OTA_BLOCK_SIZE 240U

/* Hard ceiling on the block count: bounds the loop if the glasses never reports
 * the end marker. Generous enough for a full flash image at the block size above. */
#define OTA_MAX_BLOCKS 1024U

/* Return codes from ota_run(). */
#define OTA_OK              0
#define OTA_ERR_REQUEST     (-1)
#define OTA_ERR_PREPARE     (-2)
#define OTA_ERR_READ        (-3)
#define OTA_ERR_RUNAWAY     (-4)
#define OTA_ERR_FLASH_ERASE (-5)
#define OTA_ERR_FLASH_PROG  (-6)
#define OTA_ERR_VERIFY      (-7)
#define OTA_ERR_META        (-8)

/* Firmware verification hook. Protocol (AT_Communication_Protocol.pdf +
 * dual_pin_timing) does not define a checksum field, so verification is
 * reserved but unimplemented — see docs/OTA_UPGRADE_PLAN.md §6. Returns true
 * unconditionally; fill in after the protocol is extended. */
static bool ota_verify(uint32_t addr, uint32_t size)
{
    (void)addr;
    (void)size;
    return true;
}

/* Whole frames live in static buffers: ota_run() is synchronous and not
 * re-entrant, and keeping these off the stack matters on the 8 KB SRAM part. */
#define OTA_BUF_SIZE (AT_FRAME_HEADER_SIZE + AT_FRAME_MAX_PAYLOAD)
static uint8_t ota_tx_buf[OTA_BUF_SIZE];
static uint8_t ota_rx_buf[OTA_BUF_SIZE];
static uint8_t ota_payload[AT_FRAME_MAX_PAYLOAD];

/* Tracks whether a transfer is in progress; cleared by ota_init() and on exit. */
static bool ota_active;

/* Debug counters for OTA exchange diagnostics, exposed via STATUS.
 *   last_rx_len:       hal_usart_recv return value from last ota_read_block call
 *   last_index:        block index that failed/was in progress
 *   parse_fails:       total at_frame_parse failures across all ota_read_block retries
 *   last_fail_reason:  0=none,1=magic,2=size,3=CRC,4=opcode/status,5=index mismatch,6=rx_len==0
 *   last_success_rx_len: rx_len from the last SUCCESSFUL read (tells us actual frame size received)
 * Reset on ota_init(). */
volatile uint16_t ota_dbg_last_rx_len = 0xFFFFU;
volatile uint16_t ota_dbg_last_index = 0xFFFFU;
volatile uint16_t ota_dbg_parse_fails = 0U;
volatile uint8_t ota_dbg_last_fail_reason = 0U;
volatile uint16_t ota_dbg_last_success_rx_len = 0xFFFFU;

/* One heartbeat exchange: send a heartbeat carrying the current case status with
 * the OTA flag set or cleared per request_ota, then refresh the glass status from
 * the reply. Returns true on a valid reply and reports the agree flag. */
static bool ota_heartbeat(sm_ctx_t *ctx, bool request_ota, bool *agreed)
{
    at_case_data req;
    req.role.des = AT_CASE_ROLE_GLASS;
    req.role.src = AT_CASE_ROLE_CASE;
    req.case_soc = (uint8_t)((ctx->case_soc & 0x7FU) | (ctx->glass_charging ? 0x80U : 0x00U));
    req.case_sta = (uint8_t)((ctx->lid_open ? 0x01U : 0x00U) | (request_ota ? 0x80U : 0x00U));

    uint16_t tx_len
        = at_frame_pack_request(ota_tx_buf, AT_OPCODE_CASE_HEART, (const uint8_t *)&req, (uint8_t)sizeof(req), 0U);
    hal_usart_send(ota_tx_buf, tx_len);
    uint16_t rx_len = at_frame_recv(ota_rx_buf, OTA_BUF_SIZE, OTA_TIMEOUT_MS, AT_OPCODE_CASE_HEART);
    if (rx_len == 0U) {
        return false;
    }

    uint16_t opcode = 0U;
    uint8_t status = AT_ERR_UNKNOWN;
    uint8_t plen = 0U;
    if (at_frame_parse(ota_rx_buf, rx_len, &opcode, &status, ota_payload, &plen) != AT_SUCCESS) {
        return false;
    }
    if (opcode != AT_OPCODE_CASE_HEART || status != AT_SUCCESS) {
        return false;
    }
    if (plen < (uint8_t)sizeof(at_glass_data)) {
        return false;
    }

    const at_glass_data *rsp = (const at_glass_data *)ota_payload;
    ctx->glass_present = true;
    ctx->glass_soc = (uint8_t)(rsp->glass_soc & 0x7FU);
    ctx->glass_full = (rsp->glass_soc & 0x80U) != 0U;
    ctx->reported_case_version = rsp->case_version;
    if (agreed != NULL) {
        *agreed = (rsp->glass_sta & 0x80U) != 0U;
    }
    return true;
}

void ota_init(void) { ota_active = false; }

bool ota_request(sm_ctx_t *ctx)
{
    for (uint8_t i = 0U; i < OTA_REQUEST_RETRIES; i++) {
        hal_wwdgt_feed();
        if (i > 0U) {
            hal_timer_delay_ms(OTA_REQUEST_GAP_MS);
        }
        bool agreed = false;
        if (ota_heartbeat(ctx, true, &agreed) && agreed) {
            ota_active = true;
            return true;
        }
    }
    return false;
}

bool ota_prepare(uint32_t *fw_size)
{
    at_case_role req;
    req.des = AT_CASE_ROLE_GLASS;
    req.src = AT_CASE_ROLE_CASE;

    for (uint8_t i = 0U; i < OTA_EXCHANGE_RETRIES; i++) {
        hal_wwdgt_feed();
        uint16_t tx_len = at_frame_pack_request(
            ota_tx_buf, AT_OPCODE_CASE_PACKET_PREPARE, (const uint8_t *)&req, (uint8_t)sizeof(req), 0U);
        hal_usart_send(ota_tx_buf, tx_len);
        uint16_t rx_len = at_frame_recv(ota_rx_buf, OTA_BUF_SIZE, OTA_TIMEOUT_MS, AT_OPCODE_CASE_PACKET_PREPARE);
        if (rx_len == 0U) {
            continue;
        }

        uint16_t opcode = 0U;
        uint8_t status = AT_ERR_UNKNOWN;
        uint8_t plen = 0U;
        if (at_frame_parse(ota_rx_buf, rx_len, &opcode, &status, ota_payload, &plen) != AT_SUCCESS) {
            continue;
        }
        if (opcode != AT_OPCODE_CASE_PACKET_PREPARE || status != AT_SUCCESS) {
            continue;
        }
        if (plen < (uint8_t)sizeof(at_case_packet_prepare)) {
            continue;
        }

        at_case_packet_prepare rsp;
        memcpy(&rsp, ota_payload, sizeof(rsp));
        if (fw_size != NULL) {
            *fw_size = rsp.size;
        }
        return true;
    }
    return false;
}

bool ota_read_block(uint16_t index, uint16_t block_size, uint8_t *data, uint16_t *data_len, uint8_t *type)
{
    at_case_packet_read req;
    req.role.des = AT_CASE_ROLE_GLASS;
    req.role.src = AT_CASE_ROLE_CASE;
    req.index = index;
    req.size = block_size;

    for (uint8_t i = 0U; i < OTA_EXCHANGE_RETRIES; i++) {
        hal_wwdgt_feed();
        uint16_t tx_len = at_frame_pack_request(
            ota_tx_buf, AT_OPCODE_CASE_PACKET_READ, (const uint8_t *)&req, (uint8_t)sizeof(req), 0U);
        hal_usart_send(ota_tx_buf, tx_len);
        uint16_t rx_len = at_frame_recv(ota_rx_buf, OTA_BUF_SIZE, OTA_TIMEOUT_MS, AT_OPCODE_CASE_PACKET_READ);
        ota_dbg_last_rx_len = rx_len;
        ota_dbg_last_index = index;
        if (rx_len == 0U) {
            ota_dbg_last_fail_reason = 6U;
            ota_dbg_parse_fails++;
            continue;
        }

        uint16_t opcode = 0U;
        uint8_t status = AT_ERR_UNKNOWN;
        uint8_t plen = 0U;
        at_status parse_rc = at_frame_parse(ota_rx_buf, rx_len, &opcode, &status, ota_payload, &plen);
        if (parse_rc != AT_SUCCESS) {
            ota_dbg_parse_fails++;
            /* Distinguish failure reason: AT_ERR_MAGIC=0xFE, AT_ERR_LENGTH=0x03, AT_ERR_CRC=0x06 */
            if (parse_rc == AT_ERR_MAGIC) {
                ota_dbg_last_fail_reason = 1U;
            } else if (parse_rc == AT_ERR_LENGTH) {
                ota_dbg_last_fail_reason = 2U;
            } else if (parse_rc == AT_ERR_CRC) {
                ota_dbg_last_fail_reason = 3U;
            } else {
                ota_dbg_last_fail_reason = 9U;
            }
            continue;
        }
        if (opcode != AT_OPCODE_CASE_PACKET_READ || status != AT_SUCCESS) {
            ota_dbg_parse_fails++;
            ota_dbg_last_fail_reason = 4U;
            continue;
        }
        /* The transfer header is role(2) + index(2) + type(1); data follows. */
        if (plen < (uint8_t)offsetof(at_case_packet_transfer, data)) {
            ota_dbg_parse_fails++;
            ota_dbg_last_fail_reason = 4U;
            continue;
        }

        const at_case_packet_transfer *rsp = (const at_case_packet_transfer *)ota_payload;
        if (rsp->index != index) {
            ota_dbg_parse_fails++;
            ota_dbg_last_fail_reason = 5U;
            continue;
        }
        uint16_t dlen = (uint16_t)(plen - (uint8_t)offsetof(at_case_packet_transfer, data));
        if (data != NULL) {
            memcpy(data, rsp->data, dlen);
        }
        if (data_len != NULL) {
            *data_len = dlen;
        }
        if (type != NULL) {
            *type = rsp->type;
        }
        ota_dbg_last_fail_reason = 0U;
        ota_dbg_last_success_rx_len = rx_len;
        return true;
    }
    return false;
}

/* Clear the OTA flag on both sides and let the state machine resume. A final
 * heartbeat with the flag cleared tells the glasses to leave OTA mode; the local
 * flag is dropped regardless of whether the glasses answers. */
static void ota_finish(sm_ctx_t *ctx)
{
    ota_active = false;
    ctx->ota_requested = false;
    /* Clear the reported version so sm_tick_charging/maintaining don't
     * immediately re-trigger OTA via the version-mismatch path and loop
     * forever after a failed transfer. The next heartbeat that reports a
     * mismatched version will set it again. */
    ctx->reported_case_version = 0U;
    (void)ota_heartbeat(ctx, false, NULL);
}

int ota_run(sm_ctx_t *ctx, ota_progress_cb_t progress_cb)
{
    hal_wwdgt_feed();
    ota_dbg_last_fail_reason = 0U;   /* clear at entry; set on each failure path */
    if (progress_cb != NULL) {
        progress_cb(0U);
    }

    if (!ota_request(ctx)) {
        ota_dbg_last_fail_reason = 10U;   /* REQUEST */
        ota_dbg_last_index = 0U;
        ota_finish(ctx);
        return OTA_ERR_REQUEST;
    }
    /* Drop any extra "agree" RSPs the host sent after ota_request succeeded
     * (host doesn't know firmware already exited the retry loop). They have
     * opcode HEART and would block ota_prepare's at_frame_recv filtering on
     * PREPARE — at_frame_recv leaves non-matching frames in buffer. */
    hal_usart_rx_clear();

    uint32_t fw_size = 0U;
    if (!ota_prepare(&fw_size)) {
        ota_dbg_last_fail_reason = 11U;   /* PREPARE */
        ota_dbg_last_index = 0U;
        ota_finish(ctx);
        return OTA_ERR_PREPARE;
    }
    /* Same pattern: host may send extra PREPARE RSPs; clear before READ loop. */
    hal_usart_rx_clear();

    /* Erase Staging B pages: ceil(fw_size / 1KB), capped at Staging capacity.
     * Bootloader will copy Staging → App on next reset, leaving the running
     * App untouched until the new image is fully written. */
    uint32_t staging_pages = BOOT_STAGING_SIZE / HAL_FLASH_PAGE_SIZE;
    uint32_t total_pages = (fw_size + HAL_FLASH_PAGE_SIZE - 1U) / HAL_FLASH_PAGE_SIZE;
    if (total_pages == 0U || total_pages > staging_pages) {
        ota_dbg_last_fail_reason = 12U;   /* PREPARE size out of range */
        ota_dbg_last_index = (uint16_t)total_pages;
        ota_finish(ctx);
        return OTA_ERR_PREPARE;
    }
    hal_flash_unlock();
    for (uint32_t p = 0U; p < total_pages; p++) {
        if (!hal_flash_page_erase(BOOT_STAGING_BASE + p * HAL_FLASH_PAGE_SIZE)) {
            hal_flash_lock();
            ota_dbg_last_fail_reason = 13U;   /* FLASH_ERASE */
            ota_dbg_last_index = (uint16_t)p;
            ota_finish(ctx);
            return OTA_ERR_FLASH_ERASE;
        }
    }
    /* Keep flash unlocked for the program loop — fmc_word_program needs the
     * UNLOCK bit set or the program silently no-ops (returns FMC_READY without
     * writing). Locked again after the last program completes. */

    /* Read every block and program it to Staging B. */
    static uint8_t block[OTA_BLOCK_SIZE];
    uint32_t offset = 0U;
    uint16_t index = 0U;
    uint8_t type = AT_PACKET_TYPE_MID;
    while (type != AT_PACKET_TYPE_END) {
        if (index >= OTA_MAX_BLOCKS) {
            hal_flash_lock();
            ota_dbg_last_fail_reason = 17U;   /* RUNAWAY */
            ota_dbg_last_index = index;
            ota_finish(ctx);
            return OTA_ERR_RUNAWAY;
        }
        uint16_t dlen = 0U;
        if (!ota_read_block(index, OTA_BLOCK_SIZE, block, &dlen, &type)) {
            hal_flash_lock();
            /* Preserve ota_read_block's ota_dbg_last_fail_reason (1/2/3/4/5/6/9)
             * — it tells us *why* the read failed (buffer-empty vs CRC vs
             * index-mismatch). Don't overwrite with a generic "14 = READ"
             * code, otherwise we lose the diagnostic detail. */
            ota_dbg_last_index = index;
            ota_finish(ctx);
            return OTA_ERR_READ;
        }
        if (dlen > 0U) {
            /* Flash word-program needs 4-byte alignment; pad trailing bytes with 0xFF. */
            uint32_t padded = ((uint32_t)dlen + 3U) & ~3U;
            for (uint32_t i = dlen; i < padded; i++) {
                block[i] = 0xFFU;
            }
            if (!hal_flash_write(BOOT_STAGING_BASE + offset, block, padded)) {
                hal_flash_lock();
                ota_dbg_last_fail_reason = 15U;   /* FLASH_PROG */
                ota_dbg_last_index = index;
                ota_dbg_last_rx_len = (uint16_t)(offset + dlen);  /* fail offset */
                ota_finish(ctx);
                return OTA_ERR_FLASH_PROG;
            }
            offset += dlen;
        }
        if (progress_cb != NULL && fw_size > 0U) {
            uint32_t pct = (offset * 100U) / fw_size;
            if (pct > 100U) {
                pct = 100U;
            }
            progress_cb((uint8_t)pct);
        }
        index++;
    }
    hal_flash_lock();

    if (!ota_verify(BOOT_STAGING_BASE, offset)) {
        ota_dbg_last_fail_reason = 16U;   /* VERIFY */
        ota_dbg_last_index = (uint16_t)(offset / OTA_BLOCK_SIZE);
        ota_finish(ctx);
        return OTA_ERR_VERIFY;
    }

    /* Commit: mark staged so Bootloader copies Staging → App on next reset. */
    if (!hal_bootmeta_set_staged(offset)) {
        ota_dbg_last_fail_reason = 18U;   /* META */
        ota_dbg_last_index = (uint16_t)(offset & 0xFFFFU);
        ota_finish(ctx);
        return OTA_ERR_META;
    }

    if (progress_cb != NULL) {
        progress_cb(100U);
    }
    ota_finish(ctx);

    hal_wwdgt_feed();
    NVIC_SystemReset();
    return OTA_OK; /* unreachable */
}
