Lobin0116/smart-glasses-charger/firmware/src/hal/hal_gpio.c

#include "hal_gpio.h"

#ifdef HIL_TEST
/* Mock HALL state for HIL tests. Default closed (matches cold-boot with the
 * lid shut — the common starting point for tests). */
static bool hall_mock_open = false;

void hal_hall_set_mock(bool open) { hall_mock_open = open; }
#endif

typedef struct
{
    uint32_t port;
    uint32_t pin;
} hal_pin_map_t;

/* Single source of truth that maps a logical pin to its physical port/pin.
 * The macros above each entry are defined in hal_pinmux.h. */
static const hal_pin_map_t pin_map[HAL_PIN_COUNT] = {
    [HAL_PIN_LED_RED] = {HAL_LED_RED_PORT, HAL_LED_RED_PIN},
    [HAL_PIN_LED_GREEN] = {HAL_LED_GREEN_PORT, HAL_LED_GREEN_PIN},
    [HAL_PIN_LED_2812] = {HAL_LED_2812_PORT, HAL_LED_2812_PIN},
    [HAL_PIN_LED_BLUE] = {HAL_LED_BLUE_PORT, HAL_LED_BLUE_PIN},
    [HAL_PIN_LED_WHITE] = {HAL_LED_WHITE_PORT, HAL_LED_WHITE_PIN},
    [HAL_PIN_EN_1V8] = {HAL_EN_1V8_PORT, HAL_EN_1V8_PIN},
    [HAL_PIN_CHIP_EN2] = {HAL_CHIP_EN2_PORT, HAL_CHIP_EN2_PIN},
    [HAL_PIN_TR_SWITCH] = {HAL_TR_SWITCH_PORT, HAL_TR_SWITCH_PIN},
    [HAL_PIN_POGO_IN] = {HAL_POGO_IN_PORT, HAL_POGO_IN_PIN},
    [HAL_PIN_SHIP_CTRL] = {HAL_SHIP_CTRL_PORT, HAL_SHIP_CTRL_PIN},
    [HAL_PIN_RPD] = {HAL_RPD_PORT, HAL_RPD_PIN},
    [HAL_PIN_BAT_INT] = {HAL_BAT_INT_PORT, HAL_BAT_INT_PIN},
    [HAL_PIN_CHARGER_INT] = {HAL_CHARGER_INT_PORT, HAL_CHARGER_INT_PIN},
    [HAL_PIN_COIL_INT] = {HAL_COIL_INT_PORT, HAL_COIL_INT_PIN},
    [HAL_PIN_KEY] = {HAL_KEY_PORT, HAL_KEY_PIN},
    [HAL_PIN_HALL] = {HAL_HALL_PORT, HAL_HALL_PIN},
    [HAL_PIN_I2C_SCL] = {HAL_I2C_SCL_PORT, HAL_I2C_SCL_PIN},
    [HAL_PIN_I2C_SDA] = {HAL_I2C_SDA_PORT, HAL_I2C_SDA_PIN},
    [HAL_PIN_UART_TX] = {HAL_UART_TX_PORT, HAL_UART_TX_PIN},
    [HAL_PIN_UART_RX] = {HAL_UART_RX_PORT, HAL_UART_RX_PIN},
};

void hal_gpio_init(void)
{
    /* GPIO ports live on the AHB clock domain. */
    rcu_periph_clock_enable(RCU_GPIOA);
    rcu_periph_clock_enable(RCU_GPIOB);
    rcu_periph_clock_enable(RCU_GPIOF);

    /* LEDs: push-pull output, 2MHz, initially high (active-low: low=on).
     * ODR is written BEFORE the mode switch: flipping CTL to output would
     * otherwise drive the ODR reset value (0 = LED on) for a short glitch.
     * The bootloader nails these pins high with the same ordering, so from
     * BL entry onward they never float or drive low. */
    gpio_bit_set(GPIOB, GPIO_PIN_2 | GPIO_PIN_8 | GPIO_PIN_9);
    gpio_bit_set(GPIOF, GPIO_PIN_6 | GPIO_PIN_7);
    gpio_mode_set(GPIOB, GPIO_MODE_OUTPUT, GPIO_PUPD_NONE, GPIO_PIN_2 | GPIO_PIN_8 | GPIO_PIN_9);
    gpio_output_options_set(GPIOB, GPIO_OTYPE_PP, GPIO_OSPEED_2MHZ, GPIO_PIN_2 | GPIO_PIN_8 | GPIO_PIN_9);
    gpio_mode_set(GPIOF, GPIO_MODE_OUTPUT, GPIO_PUPD_NONE, GPIO_PIN_6 | GPIO_PIN_7);
    gpio_output_options_set(GPIOF, GPIO_OTYPE_PP, GPIO_OSPEED_2MHZ, GPIO_PIN_6 | GPIO_PIN_7);

    /* Control outputs: push-pull, 2MHz, initially low. */
    gpio_mode_set(GPIOB,
                  GPIO_MODE_OUTPUT,
                  GPIO_PUPD_NONE,
                  GPIO_PIN_10 | GPIO_PIN_11 | GPIO_PIN_12 | GPIO_PIN_13 | GPIO_PIN_14 | GPIO_PIN_15);
    gpio_output_options_set(GPIOB,
                            GPIO_OTYPE_PP,
                            GPIO_OSPEED_2MHZ,
                            GPIO_PIN_10 | GPIO_PIN_11 | GPIO_PIN_12 | GPIO_PIN_13 | GPIO_PIN_14 | GPIO_PIN_15);
    gpio_bit_reset(GPIOB, GPIO_PIN_10 | GPIO_PIN_11 | GPIO_PIN_12 | GPIO_PIN_13 | GPIO_PIN_14 | GPIO_PIN_15);

    /* User inputs with pull-up (KEY, HALL). */
    gpio_mode_set(GPIOB, GPIO_MODE_INPUT, GPIO_PUPD_PULLUP, GPIO_PIN_3 | GPIO_PIN_4);

    /* BAT_INT (CW2017 ALARM, PA8) and COIL_INT (MT5706, PA12): push-pull or
     * open-drain outputs that assert low; pull-up gives a defined idle level. */
    gpio_mode_set(GPIOA, GPIO_MODE_INPUT, GPIO_PUPD_PULLUP, GPIO_PIN_8 | GPIO_PIN_12);

    /* CHARGER_INT (IP5353 INT, PA11): per IP5353 datasheet the pin is high-Z
     * while the chip is in standby and driven HIGH (push-pull) while working.
     * A pull-UP masks the standby->working transition (both states read high
     * through the pull-up), so USB plug would never produce an edge to wake
     * the MCU. A pull-DOWN instead yields:
     *   standby (high-Z) -> PA11 = LOW
     *   working (push-pull HIGH) -> PA11 = HIGH
     * so USB plug produces a clean rising edge that EXTI can latch. */
    gpio_mode_set(GPIOA, GPIO_MODE_INPUT, GPIO_PUPD_PULLDOWN, GPIO_PIN_11);

    /* I2C0: PB6 SCL / PB7 SDA, AF1 open-drain with pull-up. */
    gpio_mode_set(GPIOB, GPIO_MODE_AF, GPIO_PUPD_PULLUP, GPIO_PIN_6 | GPIO_PIN_7);
    gpio_output_options_set(GPIOB, GPIO_OTYPE_OD, GPIO_OSPEED_10MHZ, GPIO_PIN_6 | GPIO_PIN_7);
    gpio_af_set(GPIOB, GPIO_AF_1, GPIO_PIN_6 | GPIO_PIN_7);

    /* USART0: PA9 TX / PA10 RX, AF1 push-pull. */
    gpio_mode_set(GPIOA, GPIO_MODE_AF, GPIO_PUPD_PULLUP, GPIO_PIN_9 | GPIO_PIN_10);
    gpio_output_options_set(GPIOA, GPIO_OTYPE_PP, GPIO_OSPEED_50MHZ, GPIO_PIN_9 | GPIO_PIN_10);
    gpio_af_set(GPIOA, GPIO_AF_1, GPIO_PIN_9 | GPIO_PIN_10);
}

void hal_gpio_set(hal_pin_t pin, bool value)
{
    if (pin < HAL_PIN_COUNT) {
        if (value) {
            gpio_bit_set(pin_map[pin].port, pin_map[pin].pin);
        } else {
            gpio_bit_reset(pin_map[pin].port, pin_map[pin].pin);
        }
    }
}

bool hal_gpio_get(hal_pin_t pin)
{
    if (pin < HAL_PIN_COUNT) {
        return gpio_input_bit_get(pin_map[pin].port, pin_map[pin].pin) == SET;
    }
    return false;
}

void hal_gpio_toggle(hal_pin_t pin)
{
    if (pin < HAL_PIN_COUNT) {
        gpio_bit_toggle(pin_map[pin].port, pin_map[pin].pin);
    }
}

/* LEDs are active-low: driving the pin low turns the LED on. */
void hal_led_red_on(void) { hal_gpio_set(HAL_PIN_LED_RED, false); }

void hal_led_red_off(void) { hal_gpio_set(HAL_PIN_LED_RED, true); }

void hal_led_red_toggle(void) { hal_gpio_toggle(HAL_PIN_LED_RED); }

void hal_led_green_on(void) { hal_gpio_set(HAL_PIN_LED_GREEN, false); }

void hal_led_green_off(void) { hal_gpio_set(HAL_PIN_LED_GREEN, true); }

void hal_led_green_toggle(void) { hal_gpio_toggle(HAL_PIN_LED_GREEN); }

void hal_led_blue_on(void) { hal_gpio_set(HAL_PIN_LED_BLUE, false); }

void hal_led_blue_off(void) { hal_gpio_set(HAL_PIN_LED_BLUE, true); }

void hal_led_blue_toggle(void) { hal_gpio_toggle(HAL_PIN_LED_BLUE); }

void hal_led_white_on(void) { hal_gpio_set(HAL_PIN_LED_WHITE, false); }

void hal_led_white_off(void) { hal_gpio_set(HAL_PIN_LED_WHITE, true); }

void hal_led_white_toggle(void) { hal_gpio_toggle(HAL_PIN_LED_WHITE); }

void hal_led_2812_on(void) { hal_gpio_set(HAL_PIN_LED_2812, false); }

void hal_led_2812_off(void) { hal_gpio_set(HAL_PIN_LED_2812, true); }

void hal_1v8_enable(void) { hal_gpio_set(HAL_PIN_EN_1V8, true); }

void hal_1v8_disable(void) { hal_gpio_set(HAL_PIN_EN_1V8, false); }

void hal_chip_en2_enable(void) { hal_gpio_set(HAL_PIN_CHIP_EN2, true); }

void hal_chip_en2_disable(void) { hal_gpio_set(HAL_PIN_CHIP_EN2, false); }

void hal_tr_switch_set(bool value) { hal_gpio_set(HAL_PIN_TR_SWITCH, value); }

void hal_pogo_in_set(bool value) { hal_gpio_set(HAL_PIN_POGO_IN, value); }

void hal_ship_control_set(bool value) { hal_gpio_set(HAL_PIN_SHIP_CTRL, value); }

void hal_rpd_enable(void) { hal_gpio_set(HAL_PIN_RPD, true); }

void hal_rpd_disable(void) { hal_gpio_set(HAL_PIN_RPD, false); }

bool hal_key_pressed(void)
{
    /* KEY is pulled up and reads low while pressed. */
    return !hal_gpio_get(HAL_PIN_KEY);
}

bool hal_key_get(void) { return hal_gpio_get(HAL_PIN_KEY); }

bool hal_hall_get(void)
{
#ifdef HIL_TEST
    return hall_mock_open;
#else
    return hal_gpio_get(HAL_PIN_HALL);
#endif
}

bool hal_bat_int_get(void) { return hal_gpio_get(HAL_PIN_BAT_INT); }

bool hal_charger_int_get(void) { return hal_gpio_get(HAL_PIN_CHARGER_INT); }

bool hal_coil_int_get(void) { return hal_gpio_get(HAL_PIN_COIL_INT); }
