Lobin0116/smart-glasses-charger/firmware/src/hal/hal_exti.c

#include "hal_exti.h"

#include "gd32e23x.h"

/* EXTI sources on this board. Each entry wires one GPIO pad to its EXTI line
 * and selects the trigger edge; the same table feeds both init and dispatch. */
typedef struct
{
    uint8_t port;             /* EXTI_SOURCE_GPIOx for SYSCFG routing */
    uint8_t pin;              /* EXTI_SOURCE_PINx for SYSCFG routing  */
    uint8_t line;             /* EXTI line number 0..15 (callback arg) */
    exti_trig_type_enum trig; /* trigger edge(s) */
} hal_exti_src_t;

static const hal_exti_src_t exti_sources[] = {
    {EXTI_SOURCE_GPIOA, EXTI_SOURCE_PIN8, HAL_EXTI_LINE_BAT_INT, EXTI_TRIG_FALLING},
    /* CHARGER_INT (IP5353 INT, PA11): pin is high-Z in standby and driven
     * HIGH when IP5353 is working (see hal_gpio.c — PA11 has an internal
     * pull-DOWN). With that, USB plug produces a rising edge (high-Z->HIGH)
     * and USB unplug produces a falling edge (HIGH->high-Z pulled low).
     * BOTH wakes the main loop on either so refresh_case_status runs and
     * the state machine sees the new IP5353 input_valid state. */
    {EXTI_SOURCE_GPIOA, EXTI_SOURCE_PIN11, HAL_EXTI_LINE_CHARGER_INT, EXTI_TRIG_BOTH},
    {EXTI_SOURCE_GPIOA, EXTI_SOURCE_PIN12, HAL_EXTI_LINE_COIL_INT, EXTI_TRIG_FALLING},
    {EXTI_SOURCE_GPIOB, EXTI_SOURCE_PIN3, HAL_EXTI_LINE_KEY, EXTI_TRIG_FALLING},
    {EXTI_SOURCE_GPIOB, EXTI_SOURCE_PIN4, HAL_EXTI_LINE_HALL, EXTI_TRIG_BOTH},
};

#define HAL_EXTI_SRC_COUNT (sizeof(exti_sources) / sizeof(exti_sources[0]))

/* GD32E230 implements 2 priority bits (levels 0..3). All EXTI sources share one
 * level so they stay mutually cooperative. */
#define HAL_EXTI_IRQ_PRIORITY 2U

static hal_exti_callback_t exti_callback;

static exti_line_enum hal_exti_mask(uint8_t line) { return (exti_line_enum)BIT(line); }

void hal_exti_init(void)
{
    /* SYSCFG gates the registers that route GPIO pads onto EXTI lines. */
    rcu_periph_clock_enable(RCU_CFGCMP);

    for (uint32_t i = 0; i < HAL_EXTI_SRC_COUNT; i++) {
        const hal_exti_src_t *src = &exti_sources[i];
        exti_line_enum mask = hal_exti_mask(src->line);

        syscfg_exti_line_config(src->port, src->pin);
        exti_init(mask, EXTI_INTERRUPT, src->trig);
        /* Drop any edge latched before the line was armed. */
        exti_interrupt_flag_clear(mask);
    }

    /* Enable the NVIC vectors that cover the configured lines: line 3 lands in
     * EXTI2_3 and lines 4/8/11/12 land in EXTI4_15. No board pin uses EXTI
     * line 0 or 1, so EXTI0_1 keeps its default handler. */
    nvic_irq_enable(EXTI2_3_IRQn, HAL_EXTI_IRQ_PRIORITY);
    nvic_irq_enable(EXTI4_15_IRQn, HAL_EXTI_IRQ_PRIORITY);
}

void hal_exti_register_callback(hal_exti_callback_t cb) { exti_callback = cb; }

/* Serve one EXTI line from inside an ISR: clear the pending flag if the edge
 * fired and forward the line number to the registered callback. */
static void hal_exti_dispatch(uint8_t line)
{
    exti_line_enum mask = hal_exti_mask(line);
    if (SET == exti_interrupt_flag_get(mask)) {
        exti_interrupt_flag_clear(mask);
        if (exti_callback) {
            exti_callback(line);
        }
    }
}

void EXTI2_3_IRQHandler(void) { hal_exti_dispatch(HAL_EXTI_LINE_KEY); }

void EXTI4_15_IRQHandler(void)
{
    hal_exti_dispatch(HAL_EXTI_LINE_HALL);
    hal_exti_dispatch(HAL_EXTI_LINE_BAT_INT);
    hal_exti_dispatch(HAL_EXTI_LINE_CHARGER_INT);
    hal_exti_dispatch(HAL_EXTI_LINE_COIL_INT);
}
