Lobin0116/smart-glasses-charger/firmware/src/gd32e23x_libopt.h

/*!
    \file    gd32e23x_libopt.h
    \brief   library optional for gd32e23x

    \version 2026-02-04, V2.5.0, firmware for GD32E23x
*/

/*
    Copyright (c) 2026, GigaDevice Semiconductor Inc.

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
    1. Redistributions of source code must retain the above copyright notice, this
       list of conditions and the following disclaimer.
    2. Redistributions in binary form must reproduce the above copyright notice,
       this list of conditions and the following disclaimer in the documentation
       and/or other materials provided with the distribution.
    3. Neither the name of the copyright holder nor the names of its contributors
       may be used to endorse or promote products derived from this software without
       specific prior written permission.

    THIS SOFTWARE IS PROVIDED BY THE COPYRIGHT HOLDERS AND CONTRIBUTORS "AS IS"
AND ANY EXPRESS OR IMPLIED WARRANTIES, INCLUDING, BUT NOT LIMITED TO, THE IMPLIED
WARRANTIES OF MERCHANTABILITY AND FITNESS FOR A PARTICULAR PURPOSE ARE DISCLAIMED.
IN NO EVENT SHALL THE COPYRIGHT HOLDER OR CONTRIBUTORS BE LIABLE FOR ANY DIRECT,
INDIRECT, INCIDENTAL, SPECIAL, EXEMPLARY, OR CONSEQUENTIAL DAMAGES (INCLUDING, BUT
NOT LIMITED TO, PROCUREMENT OF SUBSTITUTE GOODS OR SERVICES; LOSS OF USE, DATA, OR
PROFITS; OR BUSINESS INTERRUPTION) HOWEVER CAUSED AND ON ANY THEORY OF LIABILITY,
WHETHER IN CONTRACT, STRICT LIABILITY, OR TORT (INCLUDING NEGLIGENCE OR OTHERWISE)
ARISING IN ANY WAY OUT OF THE USE OF THIS SOFTWARE, EVEN IF ADVISED OF THE POSSIBILITY
OF SUCH DAMAGE.
*/

#ifndef GD32E23X_LIBOPT_H
#define GD32E23X_LIBOPT_H

#include "gd32e23x_adc.h"
#include "gd32e23x_crc.h"
#include "gd32e23x_dbg.h"
#include "gd32e23x_dma.h"
#include "gd32e23x_exti.h"
#include "gd32e23x_fmc.h"
#include "gd32e23x_gpio.h"
#include "gd32e23x_syscfg.h"
#include "gd32e23x_i2c.h"
#include "gd32e23x_fwdgt.h"
#include "gd32e23x_pmu.h"
#include "gd32e23x_rcu.h"
#include "gd32e23x_rtc.h"
#include "gd32e23x_spi.h"
#include "gd32e23x_timer.h"
#include "gd32e23x_usart.h"
#include "gd32e23x_wwdgt.h"
#include "gd32e23x_misc.h"
#include "gd32e23x_cmp.h"

#endif /* GD32E23X_LIBOPT_H */
