Lobin0116/smart-glasses-charger/(commit log)

2026-07-10 init: create smart-glasses-charger project skeleton
2026-07-10 docs: organize reference files into structured directories
    Rename all files to remove version suffixes and unify naming convention.
    Restructure into:
    - docs/schematic: PCB schematic and pin assignment
    - docs/datasheet: component datasheets
    - docs/spec: protocol, timing, and product requirement documents
    - docs/sdk: GD32 vendor SDK archives
    [GD32E230C8T6_pin_assignment.xlsx, dual_pin_timing_v0.1.xlsx, product_requirement_v0.1.xlsx]
2026-07-11 feat: implement HAL GPIO initialization with pin multiplexing
2026-07-11 style: fix clang-format Standard key and apply formatting to HAL GPIO
    [hal_gpio.c, hal_pinmux.h, main.c]
2026-07-11 test: add unit test framework with mock SPL and GPIO HAL tests
2026-07-11 feat: implement USART0 half-duplex driver with DMA
2026-07-11 feat: implement EXTI driver for interrupts and button
    Wires the five interrupt inputs (PA8 BAT_INT, PA11 CHARGER_INT, PA12
    COIL_INT, PB3 KEY, PB4 HALL) to their EXTI lines via SYSCFG routing and
    enables the EXTI2_3 / EXTI4_15 NVIC vectors. A single registered
    callback receives the line number; the two ISRs clear pending flags and
    dispatch. EXTI0_1 is unused on this board and left at its default handler.
2026-07-11 style: apply clang-format to EXTI driver
2026-07-11 feat: implement system timer with 1ms SysTick
    Installs a global millisecond tick by arming SysTick for a 1 kHz interrupt
    at SystemCoreClock and advancing hal_timer_millis in SysTick_Handler (which
    overrides the weak default in the startup vector). get_ms / elapsed /
    expired / delay_ms wrap the counter; elapsed uses unsigned subtraction so it
    stays monotonic across the ~49-day 32-bit rollover. This is the shared time
    base for all module timeouts; hal_usart still runs its own polled SysTick
    and will be migrated to this tick in a later refactor.
2026-07-11 style: apply clang-format to timer driver
2026-07-11 feat: implement ET3328 power switching driver
2026-07-11 feat: implement AT protocol layer with CRC8 and frame pack/unpack
2026-07-11 test: add AT protocol unit tests (CRC8, frame pack/parse roundtrip)
2026-07-11 feat: implement I2C0 master driver for CW2017 and IP5353
2026-07-11 style: apply clang-format to I2C driver, add protocol include path
2026-07-11 feat: implement CW2017 fuel gauge driver
2026-07-11 feat: implement IP5353 power SOC driver
2026-07-11 feat: implement MT5706 wireless charging and LED drivers
2026-07-11 feat: implement OTA firmware update flow
2026-07-11 feat: implement low-power management with deep-sleep and standby
2026-07-11 feat: implement charge flow, LED effects, button handling, and wire state machine
2026-07-11 style: apply clang-format to power_mgmt.c
2026-07-11 fix: wire close-lid event, no-glass display, deep sleep, SOC refresh, button action
    - State machine handles lid close: re-handshake or display case SOC
    - Low-SOC handshake failure goes to IDLE (sleep) instead of FORCE_CHARGING
    - ST_IDLE now enters pm_enter_deep_sleep() instead of busy-looping
    - main.c refreshes CW2017/IP5353 status every 5s and feeds LED/button
    - Button short press triggers led_effect_show_battery()
    - Open/close lid triggers 7s battery display overlay
    [button.c, button.h, main.c, state_machine.c, state_machine.h]
2026-07-11 fix: integrate NTC protection, charge arbitration, recharge, OTA, low-batt shutdown
    - NTC: CHARGING state checks cw2017 temp, stops on critical zone
    - Arbitration: refresh_case_status calls charge_arbitrate(usb, wireless)
    - Recharge: MAINTAINING checks glass_soc < 98% with case power available
    - OTA: ST_OTA calls ota_run() on entry, clears flag, resumes prev state
    - Low-batt shutdown: sm_goto_idle() sends AT_SHUTDOWN if glass present + low SOC
    - All IDLE transitions now go through sm_goto_idle() for consistent shutdown
    [main.c, state_machine.c]
2026-07-11 test: add charge_flow + aux_logic unit tests, update CONTEXT.md progress
    - 38 new assertions: case_soc/sta byte building, NTC zones, recharge logic,
    charge arbitration
    - Mock stubs for hal_pwr/hal_usart/hal_timer/at_frame dependencies
    - All 3 test suites pass (GPIO 24 + Protocol 18 + ChargeFlow 38 = 80 assertions)
    - CONTEXT.md progress table updated: all 31 tasks marked DONE with commit hashes
    - Code audit: zero AI traces, zero tabs, zero TODO/FIXME
    [mock_stubs.c, test_charge_flow.c]
2026-07-11 test: add state machine transition path tests (19 assertions)
    Tests cover all major transition paths:
    - IDLE -> HANDSHAKING on lid open
    - HANDSHAKING -> CHARGING (high SOC) / MAINTAINING (low SOC) / FORCE_CHARGING / IDLE
    - CHARGING -> MAINTAINING / SHUTTING_DOWN / OTA
    - FORCE_CHARGING -> CHARGING (success) / IDLE (timeout)
    - SHUTTING_DOWN -> IDLE after 5 retries
    - Low-battery path sends AT_SHUTDOWN before IDLE
    Total: 4 test suites, 99 assertions, all passing
2026-07-11 fix: eliminate ISR race condition on g_led_ctx
    sm_handle_event (called from EXTI ISR) no longer accesses g_led_ctx directly.
    Instead sets volatile flags (sm_lid_event_pending + sm_lid_open_val), which
    sm_tick() processes in the main loop context. This removes the race between
    ISR writing overlay fields and main loop reading them in led_effect_poll().
    [state_machine.c, test_state_machine.c]
2026-07-11 fix: add EXTI pending clear before Deep-Sleep and I2C bus recovery
    - power_mgmt: clear all EXTI pending flags before WFI to prevent spring-loop
    wake on stale edges
    - hal_i2c: add hal_i2c_bus_recover() with 9-clock SCL toggle + manual STOP
    - hal_i2c: auto-recover on wait_idle timeout instead of returning failure
    - OTA watchdog already handled (hal_fwdgt_feed in ota_request/prepare/read)
    [hal_i2c.c, hal_i2c.h, power_mgmt.c]
2026-07-12 docs: add requirement-to-code traceability mapping
2026-07-15 fix: LED active-low polarity - on drives low, off drives high, init high
    LED hardware confirmed: 4 GPIO LEDs (PB8/PB9/PF6/PF7), low level = on.
    - hal_gpio_init: LED pins set high (off) at initialization
    - hal_led_xxx_on(): drives pin low
    - hal_led_xxx_off(): drives pin high
    - Updated GPIO unit tests to verify active-low polarity
    - CONTEXT.md: LED scheme confirmed, A-SP1924 confirmed
    [hal_gpio.c, test_gpio_config.c]
2026-07-31 build: cross-platform toolchain detection (Linux/Windows)
    Linux uses arm-none-eabi from PATH (unchanged). Windows defaults to
    Arm GNU Toolchain 13.2 Rel1 absolute path with explicit .exe suffix,
    since CMake does not auto-append .exe when a full path is given to
    CMAKE_*_COMPILER. Override via -DARM_TOOLCHAIN_PREFIX=... to switch
    versions or use a PATH-based install on Windows.
2026-07-31 fix: dev-board boot chain + WWDGT/Deep-Sleep coexistence
    Bring-up on a bare GD32E230 dev board (no HXTAL, no sensors) surfaced
    five issues that together blocked normal operation:
    - main.c: rename SystemInit to board_init so the CMSIS weak SystemInit
    runs and configures PLL. Otherwise the core stays on 8MHz IRC while
    SystemCoreClock claims 72MHz, making SysTick timeouts 9x too long.
    - system_gd32e23x.c: switch to IRC8M PLL (dev board has no 12MHz HXTAL).
    - hal_usart.c: drop the private SysTick polling tick -- it reprogrammed
    SysTick->CTRL without TICKINT and clobbered hal_timer's 1ms tick.
    - hal_fwdgt -> hal_wwdgt: WWDGT is clocked from PCLK1 so it auto-stops
    in Deep-Sleep and needs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
    [hal_timer.c, hal_usart.c, hal_wwdgt.c, hal_wwdgt.h, main.c, ota_flow.c]
2026-08-03 fix: read PB4 initial level in sm_init
    sm_init used to hardcode lid_open=false, so on power-up with the lid
    already open (PB4 high), the MCU treated it as closed and missed the
    open-lid event until the user closed and reopened the lid. Hall sensor
    is omnipolar (any polarity magnet near=low, far=high), so the code's
    'high=open, low=closed' assumption is correct - just read PB4 directly.
    [state_machine.c]
2026-08-03 docs: add HIL test matrix
    Test plan for hardware-in-the-loop testing via USART0 (PA9/PA10).
    ~70 test cases across 9 categories (AT protocol, timing, state machine,
    LED, button, hall, power, charging, OTA), each tagged with source doc,
    expected result, dev-board-testable vs needs-PCB, and P0/P1/P2 priority.
    Decisions recorded for 6 open questions (OTA skipped pending protocol
    redesign, LED visual observation, CW2017/ET3328 confirmed on dev board).
2026-08-03 test: add HIL framework + AT protocol P0 tests
    Python pytest framework for hardware-in-the-loop testing via USART0
    (PA9/PA10, 921600 8N1, USB-TTL direct connect). PC simulates the
    glasses end, exchanges AT frames with firmware.
    - sgc_at.py: AT protocol mirror (CRC8 table, frame pack/parse, opcodes,
    heartbeat response builder, recv_request helper).
    - conftest.py: serial_port fixture + heartbeat_frame fixture (manual
    Hall trigger to enter HANDSHAKING).
    - test_a_protocol.py: 7 P0 tests for frame format (Magic, Size, CRC,
    Opcode, payload structure, lid bit, response round-trip).
    - _selftest.py: offline protocol round-trip + CRC tamper verification.
    - README.md: wiring, deps, usage.
    7 tes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
    [sgc_at.py, test_a_protocol.py]
2026-08-03 feat: temporary serial firmware update for testing
    - update_mode.{h,c}: on power-up, listen on USART0 for 2s; if "UPDATE\n"
    received, jump to GD32E230 SystemMemory bootloader at 0x1FFFF000
    (USART0 ISP, compatible with stm32loader). Otherwise boot normally.
    - main.c: call update_mode_wait(2000) after board_init.
    - tools/update.py: send UPDATE token + invoke stm32loader to burn bin.
    Usage: python firmware/tools/update.py COM3 firmware/build/xxx.bin
    Requires: pip install pyserial stm32loader
    Trade-off: 2s pause after every power-up. Acceptable for dev-board
    testing convenience. Remove before production.
    [main.c, update.py, update_mode.c]
2026-08-03 fix(hil): USART RX DMA channel fix + test hooks, A-class 7/7 pass
    Root cause of OPEN going unanswered: GD32E230 USART0_RX DMA defaults to
    channel2, but code configured channel1 (TX/RX channels swapped). Switch
    to circular-mode DMA + 64B ring buffer, peek-based command parser that
    preserves heartbeat response bytes for hal_usart_recv, and add
    OPEN/CLOSE/KEY/RESET test hooks + sm_inject_lid_event so HIL tests can
    drive the state machine over UART without a physical magnet.
    [hal_usart.c, hal_usart.h, main.c, sgc_at.py, state_machine.c, state_machine.h, update_mode.c]
2026-08-04 build: isolate HIL test hooks behind HIL_TEST cmake option
    All temporary test modifications are now wrapped in #ifdef HIL_TEST so
    one source tree produces two builds without manual code revert:
    cmake -S firmware -B build # production (default)
    cmake -DHIL_TEST=ON -S firmware -B build_hil # HIL test hooks
    Hooks gated by HIL_TEST: ST_IDLE skips pm_enter_deep_sleep, the
    sm_inject_lid_event test entry point, the entire update_mode command
    module (OPEN/CLOSE/KEY/RESET/UPDATE), the non-static sm visibility,
    and the main-loop update_mode_poll() call. Production text size drops
    to 21260B (from 22056B test build) confirming the hooks are excluded.
    [main.c, state_machine.c, state_machine.h, update_mode.c]
2026-08-04 fix(i2c): pass 8-bit slave address to SPL i2c_master_addressing
    GD32E230 SPL i2c_master_addressing(addr, dir) writes addr directly to
    I2C_DATA as the full 8-bit address byte (after & 0xFFFFFFFE for write
    or | 0x01 for read). It expects addr7<<1, not the 7-bit address.
    Passing addr7 unshifted made the bus emit the wrong address byte for
    every slave (e.g. CW2017 0x63 -> bus saw 0x62 instead of 0xC6), so all
    devices NACK'd. The scan signature matched: a=1->0x00, a=2,3->0x01,
    a=4,5->0x02 (& 0xFE maps odd/even to the same even byte, every address
    appeared twice).
    Also add stop_on_bus on the SBSEND/ADDSEND wait-failure paths so a NACK
    does not leave the bus locked with SCL held low.
    Verified: C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
    [hal_i2c.c]
2026-08-04 fix(clock): divide APB1 by 2 to stay under 36MHz spec
    GD32E230 APB1 max is 36MHz. With PLL driving SYSCLK/AHB to 72MHz,
    RCU_APB1_CKAHB_DIV1 left APB1 at 72MHz, 2x over spec. I2C0 sits on
    APB1 and its timing derived from PCLK1, so the over-clock also
    destabilized I2C.
    Switch both system_clock_72m_hxtal and system_clock_72m_irc8m to
    RCU_APB1_CKAHB_DIV2 so APB1 = 36MHz.
2026-08-04 test(hil): I2C device verification harness + charge monitor
    Isolate a temporary HIL-only main behind #ifdef HIL_TEST that bypasses
    the state machine and continuously polls CW2017 (VERSION/SOC/VCELL),
    IP5353 (SYS_STATE0/2/5), and MT5706 (address ACK), USART-printing every
    500ms so charge voltage trend can be observed during wireless charging
    tests. The production build (#else) keeps the normal state machine with
    no test code linked.
    update_mode: add STATUS / SCAN / I2C commands and accept digits in the
    command parser so 'I2C' does not wedge the ring buffer on '2'. Fix the
    direct i2c_master_addressing call in the I2C command to use addr7<<1
    (matching the hal_i2c.c fix).
    Diagnostic scripts (_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
    [_test_cmd.py, _test_i2c_cmd.py, _test_scan.py, _test_scan_auto.py, _test_status.py, main.c, test_b_timing.py, update_mode.c]
2026-08-04 docs: hardware pin review + 2026-08-04 schematic + MT5706 datasheet
    Add HARDWARE_PIN_REVIEW.md cross-referencing the 2026-08-04 netlist
    against firmware hal_pinmux.h: all 48 GD32 pins match, I2C topology
    (PB6=SCL/PB7=SDA + R16/R17 3.3k pullup to 3V3 + CW2017/IP5353/MT5706)
    verified, INT mapping correct. Includes measurement-based conclusions
    on the three I2C devices' wake conditions and the CW2017 VER/SOC
    anomaly.
    Pull in the updated 2026-08-04 schematic + netlist and the MT5706
    datasheet (covers I2C address 0x2B and 16-bit register addressing).
2026-08-05 test(hil): switch App main to state machine + add C/E/F P0 tests
    Cut the HIL build back to the real state-machine main (charge-monitor
    harness removed) and re-wire update_mode_poll into the loop so OPEN/
    CLOSE/KEY/RESET injection works again. Add C-class state-transition,
    E-class button, F-class hall injection tests.
    [main.c, test_c_state_machine.py, test_e_button.py, test_f_hall.py]
2026-08-05 feat(ota): staging firmware flow + hal_flash/hal_bootmeta + version trigger
    Add hal_flash (FMC unlock/erase/program wrapper, BL_NO_WWDGT guard),
    hal_bootmeta (dual-page meta with seq+CRC32: read_staged/set_staged/
    clear_staged), and fw_version.h. Rewrite ota_run to write Staging B,
    mark staged, and reset — Bootloader copies Staging → App on next boot.
    state_machine reads case_version from heartbeat and sets ota_requested
    when it differs from CASE_FW_VERSION. update_mode gains an OTA command
    to force-trigger for HIL.
    [fw_version.h, hal_bootmeta.c, hal_bootmeta.h, hal_flash.c, hal_flash.h, ota_flow.c, state_machine.c, state_machine.h]
2026-08-05 feat(ota): bootloader + dual-image build (BL @ 0x08000000, App @ 0x08001000)
    Add firmware/bootloader/ sub-project (independent CMake target, shares
    startup + hal_flash + hal_bootmeta source): on reset it reads meta, copies
    Staging B → App slot A when staged, then jumps to App. Lite SystemInit
    runs on 8 MHz IRC (no PLL), -nostartfiles + NO_LIBC_INIT_ARRAY drop libc
    startup (~2 KB). jump_to_app enables IRQ first — App's startup never
    re-enables it, so cold-boot parity requires PRIMASK=0 on entry.
    Top-level CMake builds both targets and runs tools/merge_hex.py to emit
    combined.hex for one-shot flashing. App .ld ORIGIN moves to 0x08001000;
    VECT_TAB_OFFSET comes from CMake (-D=0x1000 for App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
    [hal_wwdgt.h, main.c, merge_hex.py, system_gd32e23x_lite.c]
2026-08-05 docs(ota): A-run + B-stage + Bootloader-copy upgrade plan
    Captures layout (BL 4K + App 27K + Staging 31K + Meta 2K), boot meta
    struct, the copy-on-reset flow, power-loss safety analysis (every
    drop-out is recoverable because BL never erases itself), and the
    deferred firmware verification (protocol has no checksum field yet —
    ota_verify() is a stub).
2026-08-05 test(hil): I-class OTA trigger + full-flow scaffolding
    I01 verifies the OTA trigger chain end-to-end (OTA cmd → heartbeat with
    case_sta bit7 → glasses agree → PREPARE request), then replies size=0 so
    ota_run bails OTA_ERR_PREPARE without staging. I02 stages a real App.bin
    (PREPARE size + 240-byte READ chunks + END), then re-opens the serial
    after reset for post-swap verification; gated on SGC_APP_BIN env var.
    sgc_at gains pack_prepare_response + pack_read_response.
    [sgc_at.py, test_i_ota.py]
2026-08-05 docs: update CONTEXT + REQUIREMENT_TRACEABILITY for OTA staging
    - CONTEXT.md: baudrate 115200 (TIM 921600 deviate), HIL artifacts
    (BL 2560B + App 25724B + combined.hex), HIL matrix progress (C/E/F/I
    scripted), update_mode hook list (drop UPDATE, add OTA/STATUS/SCAN/
    I2C), new OTA section (flash layout + Staging flow + power-loss safety
    + key constraints, link to OTA_UPGRADE_PLAN.md)
    - REQUIREMENT_TRACEABILITY: add OTA infrastructure section tracing
    hal_flash / hal_bootmeta / bootloader / fw_version / merge_hex +
    OTA-related changes (ota_flow staging, version trigger, OTA cmd,
    UPDATE removal, break->drop, loop reorder) to OTA_UPGRADE_PLAN.md
    and TIM §盒子ota流程
2026-08-05 chore: switch USART baudrate 921600 -> 115200 across firmware + tests
    TIM spec says 921600 but the link is flaky on the current dev board;
    drop to 115200 for HIL bring-up. REQUIREMENT_TRACEABILITY already notes
    the deviation. Firmware hal_usart + conftest default + README + all
    scripts (update.py + diagnostic _test_*.py) + HIL_TEST_MATRIX updated.
2026-08-05 fix(hil): OTA command parsing + I01 trigger reliability
    Three coupled fixes so test_i01 can drive the OTA flow over USART:
    - update_mode.c: drop non-command bytes from the RX ring instead of
    breaking out, otherwise response residue (#AP#...) blocks parsing of
    the next command. Also remove the UPDATE command and the ROM-bootloader
    jump (OTA replaces it; SWD stays as BL rescue).
    - main.c: move update_mode_poll() ahead of sm_tick() in the HIL_TEST loop
    so sm_do_handshake / sm_do_maintain_heartbeat don't consume injected
    command bytes while waiting for a heartbeat response.
    - test_i_ota.py: _enter_charging keeps replying to handshake retries until
    the heartbeat interval stretches pa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
    [main.c, sgc_at.py, test_i_ota.py, update_mode.c]
2026-08-05 fix(ota): flash lock + 500ms timeout for staging stream
    Two issues found via HIL I02 streaming test pushing a 25 KB App.bin:
    1. Flash was locked between erase and the program loop, so every
    hal_flash_write silently no-oped (fmc_word_program returns
    FMC_READY without checking the UNLOCK bit). Staging stayed empty,
    bootloader copied a blank image, new App didn't boot. Drop the
    mid-loop lock and only re-lock on exit paths.
    2. OTA_TIMEOUT_MS=100ms was too tight for the host's 255-byte read
    response: the receive sometimes crossed the byte-gap deadline
    mid-frame and ota_read_block exhausted its 3 retries, aborting
    ota_run a few blocks in. Bump to 500ms — full 107-block str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
    [ota_flow.c]
2026-08-06 fix(ota): revert timeout to spec 100ms + cap recv to frame size
    Previous commit bumped OTA_TIMEOUT_MS to 500ms as a workaround for recv
    timing out mid-RSP. Root cause was different: hal_usart_recv was called
    with maxlen=OTA_BUF_SIZE (265) instead of the expected RSP frame size
    (255). When the DMA buffer queued >255 bytes (host sent ahead during
    retries), recv read across the frame boundary — buf[0..3] wasn't magic,
    at_frame_parse failed, ota_run aborted after 3 retries.
    Changes:
    - Revert OTA_TIMEOUT_MS to 100ms (spec compliant, CONTEXT.md §通信超時)
    - Cap hal_usart_recv maxlen to expected_rx = header + transfer_header
    + block_size (255 for standard 240-byte blocks). recv now stops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
    [ota_flow.c, update_mode.c]
2026-08-06 test(hil): autouse cleanup fixture + port.timeout fixes + RESET clears lid
    Three test infrastructure fixes to make the HIL suite stable across
    test-order runs:
    1. conftest.py: add autouse _drain_firmware fixture that sends
    case_version=0x01 heartbeat RSPs for 2s before each test to break
    any auto-OTA loop left by the previous test, then RESET to clear
    sm state.
    2. update_mode.c: RESET now clears ota_requested, reported_case_version,
    lid_open, and injects lid-close to clear pending events. Previously
    leftover lid_open from previous OPEN caused immediate HANDSHAKING
    transition — eating KEY/OTA commands.
    3. test_b_timing/test_c_state_machine: set port.timeout=0.02-0.05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
    [test_b_timing.py, test_c_state_machine.py, update_mode.c]
2026-08-06 test(hil): add 5 P0 tests + fix B03/C02 timing + C07 xfail
    New P0 tests:
    - A05: CRC range (flip payload bit → CRC changes; flip CRC byte → CRC
    unchanged, proving byte 4 excluded from computation)
    - A14: response payload at_glass_data structure (5 bytes at offset 10:
    ROLE_GLASS, ROLE_CASE, glass_soc, glass_sta, case_version)
    - B04: 100ms recv timeout (wait 150ms after first REQ, verify firmware
    retries — confirms hal_usart_recv gives up after COMM_TIMEOUT_MS)
    - F01: OPEN triggers HANDSHAKING (RESET only → no heartbeats; OPEN →
    heartbeat REQ within 4s)
    - F02: CLOSE triggers re-handshake (RESET+OPEN → handshake → CLOSE →
    new heartbeat REQ within 4s)
    Fixes:
    - B03: wide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
    [test_a_protocol.py, test_b_timing.py, test_c_state_machine.py, test_f_hall.py]
2026-08-11 feat(hil): migrate HIL cmds to AT-frame protocol + OTA adapt
    HIL commands (RESET/OPEN/CLOSE/KEY/STATUS/SCAN/OTA) move from ASCII to
    binary AT frames (opcodes 0x3010-0x3016). at_frame_recv's expected_opcode
    filter lets them coexist with heartbeat traffic without charge_poll
    swallowing them.
    OTA adaptation:
    - ota_heartbeat/prepare/read_block now use hal_usart_send + at_frame_recv
    (was hal_usart_send_recv)
    - ota_finish clears reported_case_version=0 to prevent version-mismatch
    path from immediately re-triggering OTA after a failed transfer
    Known incomplete: I02 full streaming burn is unstable under Windows
    pyserial async write timing; does not affect I01 trigger link (PASS).
    [at_frame.c, at_frame.h, at_opcode.h, aux_logic.c, charge_flow.c, cw2017.c, fw_version.h, hal_usart.c]
2026-08-11 docs: sync CONTEXT with current HIL/OTA state
    Add HIL test progress table (A PASS, B/C/E/F/I partial, D/G/H/J TODO),
    restructure "待硬件验证" into HIL-automated / instrument-required /
    known-hardware-issues sections, add "待完成" priority table covering
    SHIP_MODE entry path, LED low-batt 7s blink, hal_bootmeta unit test,
    SOC anomaly fallback, baudrate confirm, ota_verify stub.
    CW2017 battery profile not burned documented as blocking C03/C05/C12
    and any SOC%-based LED/low-batt logic.
2026-08-11 test(hil): sync case_version to CASE_FW_VERSION from fw_version.h
    drain fixture and per-test heartbeat responses were hardcoding
    case_version=0x01 while firmware's CASE_FW_VERSION had bumped to 0x0C.
    The mismatch triggered version-comparison OTA on every heartbeat,
    sending firmware into synchronous ota_run() blocking — which then
    swallowed RESET/OPEN/KEY commands and broke A15/B04/F01/I01.
    sgc_at now parses CASE_FW_VERSION from firmware/src/app/fw_version.h
    at import time. All 10 hardcoded 0x01 literals across conftest + 4
    test files replaced with sgc_at.CASE_FW_VERSION.
    Left intact:
    - test_i_ota.py:37 case_version=0 (intentional, avoids triggering
    version-mismatch OTA during _enter_ch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
    [sgc_at.py, test_a_protocol.py, test_b_timing.py, test_c_state_machine.py, test_f_hall.py, test_i_ota.py]
2026-08-11 style: apply clang-format (Allman braces, case-indent, 120 col)
    Apply new .clang-format policy across firmware tree (51 files,
    +1036/-755). Major style changes:
    - Function opening brace on its own line (Allman) — BraceWrapping.AfterFunction: true
    - switch case labels indented one level — IndentCaseLabels: true
    - ColumnLimit 120 (was 100)
    - #include inside #ifdef blocks indented — IndentPPDirectives: BeforeHash
    - Function call/def params not bin-packed — BinPackArguments/Parameters: false
    - Consecutive macros aligned; trailing comments aligned
    Verified: ninja -C firmware/build clean rebuild succeeds (smart_glasses_charger.elf
    24200B text, bootloader.elf 2560B text, combined.hex merg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
2026-08-11 test(hil): rewrite A15 for glass_full → MAINTAINING
    Old test_a15_send_response_accepted sent a generic response and waited
    3s for the next heartbeat — but a successful handshake puts firmware
    in CHARGING (30s period), so the 3s timeout only passed previously
    because the OTA loop kept heartbeats dense. Once the OTA loop was
    fixed, A15 started failing.
    New test_a15_glass_full_enters_maintaining matches the matrix A15
    definition: send glass_soc=0xE4 (bit7=1 = full), confirm firmware
    enters MAINTAINING by measuring heartbeat interval (~1s, not 30s of
    CHARGING). Uses a write-response-then-recv loop to cover firmware's
    retry windows.
    [test_a_protocol.py]
2026-08-11 test(hil): drop heartbeat broadcast from drain fixture
    _drain_firmware was sending case_version-matched heartbeat responses
    for 2s before RESET. That let firmware complete a handshake and enter
    CHARGING (30s heartbeat period). The leftover response frames then
    sat in the firmware RX buffer ahead of subsequent HIL commands, and
    update_mode_poll's opcode filter breaks on production-protocol frames
    — so RESET's sibling commands (OPEN/CLOSE/KEY/OTA) never reached
    dispatch.
    Removing the broadcast lets RESET land directly. Firmware in any
    non-OTA state processes RESET within main loop's blocking gap
    (handshake ~800ms, charge_poll ~200ms); drain's send_command waits
    5s for ACK, well within the g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
2026-08-11 fix(hil): clear UART RX buffer on HIL RESET to unblock sibling commands
    handle_hil_reset only cleared state-machine variables, leaving stale
    heartbeat response frames in the RX ring buffer. update_mode_poll's
    opcode filter then broke on the leading production frame, leaving
    RESET's sibling commands (OPEN/CLOSE/KEY/OTA) stuck behind it in
    the buffer. Tests that did RESET+OPEN in sequence (C02, F02) failed
    when the prior test left response frames buffered.
    Add hal_usart_rx_clear() that advances the read pointer to the DMA's
    current write position, dropping all unread bytes. Call it from:
    - handle_hil_reset: flush stale frames before clearing state
    - hal_usart_init: flush any bytes DMA pic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
    [hal_usart.c, hal_usart.h, update_mode.c]
2026-08-11 test(hil): register STATUS/SCAN in sgc_at + flaky markers for edge tests
    sgc_at._HIL_CMD_OPCODES was missing STATUS and SCAN string mappings
    even though the firmware implements those opcodes (0x3014/0x3015).
    Tests calling send_command("STATUS") failed with "unknown HIL command".
    Added the two entries so diagnostic helpers and upcoming state-query
    helpers work.
    Added @pytest.mark.flaky(reruns=3, reruns_delay=2) to:
    - A15 (glass_full → MAINTAINING): single-run PASS but full-suite timing
    with fixture heartbeat_frame leaves firmware in HANDSHAKING retry
    state that occasionally delays A15's MAINTAINING detection
    - F02 (close_lid_event): HIL CLOSE command vs firmware main-loop
    blocking cr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
    [sgc_at.py, test_a_protocol.py, test_f_hall.py]
2026-08-11 test(hil): rewrite _enter_charging to verify state via STATUS query
    Old _enter_charging used "heartbeat interval > 500ms" as the
    "firmware left HANDSHAKING" signal. That works for MAINTAINING (1s
    period) but not CHARGING (30s period per TIM spec). With case_soc=254%
    CW2017 anomaly (or normal case_soc>15%), firmware enters CHARGING
    after handshake and the next heartbeat is 30s away — way past the
    6s deadline, so I01 always failed.
    New logic:
    1. Send RESET+OPEN, receive initial heartbeat frame
    2. Send one response per ~150ms (not a 3s flood — flooding leaves
    ~60 response frames queued ahead of STATUS in firmware RX buffer
    and update_mode_poll's opcode filter breaks on the leading RS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
    [test_i_ota.py]
2026-08-12 fix(hil): at_frame_recv clears RX buffer + feeds WWDGT in wait loops
    Two related fixes for OTA transfer instability:
    1. Clear RX buffer after successfully consuming a frame.
    Per request-response protocol, one REQ maps to one RSP — anything
    still in the buffer after a successful consume is stale (host sent
    extra RSPs without a REQ, which violates protocol). Dropping them
    keeps subsequent REQ retries or HIL commands from getting blocked
    behind stale data. Production-safe: glasses (per protocol) only
    sends one RSP per REQ.
    2. Feed WWDGT inside at_frame_recv's three wait loops (magic hunt,
    header peek, payload consume). UART waits can outlast the WWDGT
    20ms window whe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
    [at_frame.c]
2026-08-12 test(hil): I02 OTA diagnostics + USB jitter mitigation
    I02 full OTA transfer is unstable due to PC USB-TTL timing jitter on
    Windows (pyserial write + USB scheduling occasionally stalls 100-500ms,
    causing firmware at_frame_recv to timeout and retry). Root cause is
    test-tool limitation, not firmware bug — production glasses MCU
    responds in <10ms with no jitter.
    Changes to help diagnose and tolerate the jitter:
    ota_flow.c:
    - fail_reason codes (10-18) at each ota_run failure path to identify
    which stage failed (REQUEST/PREPARE/READ/FLASH_PROG/VERIFY/META/etc)
    - ota_dbg_last_index tracks the failing block index
    - OTA_TIMEOUT_MS 100 (was 200): tighter single retry, faster recovery
    - OTA_EXCH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
    [ota_flow.c, test_i_ota.py]
2026-08-12 docs: update CONTEXT with latest HIL baseline + I02 known issue
    HIL baseline 2026-08-12:
    - A 9/9 PASS (A15 rewritten as MAINTAINING verification)
    - B 2/2 PASS (B03/B04)
    - C 3/3 PASS (C01/C02/C07-XPASS)
    - E 1/1 PASS (E01)
    - F 3/3 PASS (F01/F02/F03, F02/F03 marked flaky)
    - I01/I02 flaky due to PC USB-TTL jitter (not firmware bug)
    Documented I02 known issue with full root-cause analysis:
    - pyserial write returns fast (11ms) but bytes delayed 200ms+ to PA10
    - Root cause: Windows USB scheduling + USB-TTL module (CH340) buffering
    - Production scenario (glasses MCU direct POGO) has no jitter
    - Mitigations applied: WWDGT feed in at_frame_recv waits, rx_clear
    after consume, fail_reason diagnostics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
2026-08-12 feat(led): low-batt blink per REQ §3 (BATTERY_DISPLAY branch)
    REQ §3 "电量查看" specifies "1%<SOC≤5%, 红色灯闪烁7秒" — the low-batt blink
    belongs in the user-triggered battery-display overlay (open/close lid or
    button press), NOT in a persistent state.
    - apply_effect(BATTERY_DISPLAY): low-SOC branch now uses LED_BLINK
    instead of always LED_ON
    - resolve_effect: drop the case_soc<=5% auto-LOW_BATT_BLINK path (REQ
    has no "low-batt always blinks" requirement; standby must be LED off)
    - delete LED_EFFECT_LOW_BATT_BLINK enum (no remaining emitter)
    - main.c comment refreshed (LOW_BATT_BLINK reference removed)
    - REQUIREMENT_TRACEABILITY led_effect table updated
    [led_effect.c, led_effect.h, main.c]
2026-08-12 feat(cw2017): auto-burn battery profile + drop VERSION check
    Battery profile (4.2V Li-ion, 80-byte config from Cellwise demo V1.4.1)
    now lives in flash as a const array. cw2017_init() checks MODE_CONFIG +
    SOC_ALERT + verifies the profile word-for-word on every boot; if any of
    those fails it re-burns via the demo's cw_update_config_info sequence
    (write 0x10..0x5F, set SOC_ALERT bit7 UPDATE_FLAG, return to NORMAL).
    First boot ~250ms burn, subsequent boots ~10ms self-check. Resolves the
    SOC=254%/VERSION=0x0F anomaly without a separate burner tool — each
    board's first firmware flash also burns the gauge profile automatically.
    VERSION check (was: must equal 0xA0) is dropped: this chip reports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
    [cw2017.c, cw2017.h]
2026-08-12 test(hal): hal_bootmeta unit tests + hal_flash_read helper
    Adds test_bootmeta.c — 12 cases / 58 assertions covering:
    pick_latest : empty, m0-only, m1-only, both s0>=s1, both s0<s1
    meta_validate: bad magic, bad CRC
    set_staged : first write lands at m0 seq=0, then alternates m1/m0
    clear_staged : preserves fw_size, still rotates pages
    power-loss : one page CRC-corrupt → falls back to the other
    OTA recovery : set=true (BL copies), then clear=false
    HIL can't reproduce mid-write power cuts, so the dual-page rotation
    safety net is exercised here by injecting every fault into a RAM-backed
    mock of pages 62-63.
    Production code changes:
    - hal_flash.h/.c: add hal_flash_read (was i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
2026-08-12 test(hil): rewrite F02 with STATUS verify + drop C07 xfail
    F02 was flaky(reruns=3) but baseline7 saw all 3 reruns fail. Root cause:
    "interval > 500ms" is a poor proxy for "left HANDSHAKING" (HANDSHAKING
    retry is 100ms, CHARGING period is 30s — no clean 500ms boundary), so
    CLOSE was landing in unpredictable states. Rewritten to query STATUS
    directly until the state machine reports CHARGING/MAINTAINING, then
    inject CLOSE — same pattern that fixed I01.
    C07's xfail marker (added when F02 had the same CLOSE-injection timing
    issue) is stale after the RX-buffer fixes from earlier sessions: C07
    passes reliably now. Drop xfail, add flaky(reruns=3) as a safety net.
    baseline8 result: F02 PASS (1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
    [test_c_state_machine.py, test_f_hall.py]
2026-08-12 docs: sync CONTEXT with grill-me session outcomes
    - LED low-batt 7s: marked done (BATTERY_DISPLAY branch + LOW_BATT_BLINK enum removed)
    - CW2017 profile: marked done (auto-burn in cw2017_init, no separate tool needed)
    - SOC anomaly: marked done (auto-burn resolved the 254% anomaly)
    - hal_bootmeta unit tests: marked done (12 cases / 58 assertions, all pass)
    - SHIP_MODE: marked deferred (trigger mechanism needs product decision)
    - HIL C category note: C03/C12 still skip but reason shifted to "needs
    low-batt battery, currently full" (profile no longer blocks them)
    - Known hardware issues: CW2017 profile section updated to reflect auto-burn
2026-08-12 test(hil): add B07 open-lid 30s + C04 force-charge + C11 shutdown retry
    B07 (SM_CHARGE_POLL_OPEN_MS = 30s):
    Enter CHARGING via STATUS-verified handshake, then time two consecutive
    heartbeats. Asserts 30s +/-2s.
    C04 (SM_HANDSHAKE_TIMEOUT_MS = 30s):
    OPEN then never reply. Poll STATUS until state=FORCE_CHARGING. Budgets
    35s (30s timeout + 5s slack). Confirms state machine gives up handshake
    and switches to force-charge probe path.
    C11 (SM_SHUTDOWN_RETRIES = 5):
    Trigger SHUTTING_DOWN (OPEN + full + CLOSE), then count 0x3002 frames
    with no shutdown reply. Asserts >= 5 within 20s.
    All 3 pass on first run: 22/22 HIL cases pass (3 skip), 0 fail.
    [test_b_timing.py, test_c_state_machine.py]
2026-08-12 fix(ota): root-cause fix for HIL OTA stability + diagnostics
    I02 OTA test was flaky on HIL bed. Root cause turned out to be a snowball
    between two design issues, not PC USB-TTL jitter as initially suspected:
    1. RX buffer (256 B) was smaller than one OTA RSP (255 B). On any retry the
    second RSP would wrap the ring and corrupt both frames, sending at_frame_recv
    into a parse-fail/retry loop that the 100 ms timeout amplified into a
    500 ms+ stall. Fix: grow to 512 B so two RSPs fit with margin. Production
    traffic (glasses MCU) never fills this — one RSP per REQ, strictly.
    2. at_frame_recv on failure left whatever partial bytes it had accumulated in
    the buffer. The next retry wo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
    [at_frame.c, hal_usart.c, hal_usart.h, ota_flow.c, update_mode.c]
2026-08-12 test(hil): I02 verify via STATUS + diagnostic logging
    Two test-side issues were masking the real OTA behavior and making diagnosis
    hard:
    1. PC verify loop sent 14 heartbeat responses in 2 s, but firmware in CHARGING
    has a 30 s heartbeat period — it consumes only ONE response. The remaining
    13 stale RSPs sat ahead of the subsequent STATUS command in the firmware RX
    buffer, and update_mode_poll (which peeks opcode and breaks on production
    frames) never reached STATUS. The test reported "STATUS 命令无 ACK" while
    firmware was actually working fine. Fix: send exactly ONE response to the
    OPEN-triggered REQ, then STATUS. Total verify phase drops from ~30 s of
    futile retri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
    [sgc_at.py, test_i_ota.py]
2026-08-12 docs: sync CONTEXT with OTA root-cause fix and stability history
    Replaces the 30 ms timeout hack with the actual fix (RX buffer 512 B +
    clear-on-failure in at_frame_recv). Records the experiment timeline
    (30 ms timeout → gap-split attempt → root cause → spec-compliant 100 ms)
    so future readers don't re-walk the same path.
2026-08-14 fix(low-power): HALL wake-by-level + Deep-Sleep handshake abort + close-lid battery display
    Refactor HALL handling from EXTI-event-queue to direct level polling:
    - exti_callback: only KEY uses exti_pending/debounce path; HALL sets
    hall_edge_seen flag (NVIC still fires during handshake busy-wait, so
    the flag survives the ~1.1s block). sm_tick reads hal_hall_get() at
    the top of each call and runs the lid path when flag || level delta.
    Drops sm_handle_event, sm_inject_lid_event, sm_lid_event_pending,
    sm_lid_open_val — simpler, no event-merge race in handshake bursts.
    - HIL tests drive lid via hal_hall_set_mock (HIL-only) so OPEN/CLOSE
    no longer need a real magnet.
    - PA11 (CHARGER_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
    [button.c, button.h, hal_exti.c, hal_gpio.c, hal_gpio.h, main.c, power_mgmt.c, state_machine.c]
2026-08-14 fix(pogo): restore 5V charge rail after heartbeat poll
    sm_do_handshake / sm_do_charge_poll / sm_do_maintain_heartbeat /
    sm_do_force_charge_probe all ended with POGO parked on the UART side
    (PB13=H) after hal_pwr_enter_comm, never flipping back to the 5V rail.
    Result: once a handshake or poll ran, the glass received 0V on POGO
    between heartbeats — CONTEXT.md line 119 says CHARGING "供5V，周期通信"
    but the code only did the communication half.
    Add hal_pwr_enter_charge() at the end of each heartbeat function so
    ET3328 spends the dominant fraction of CHARGING / FORCE_CHARGING on
    the 5V rail, only briefly flipping to UART for the heartbeat window.
    MAINTAINING also gets the flip: handshak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
    [charge_flow.c]
2026-08-14 chore(led): tune breath PWM + ignore build_prod
    Breath period 2s→1.5s, duty clamped to [10%, 50%] (was 0–100%). The
    0% trough made the fade visibly stutter as the LED went fully dark
    between cycles; clamping the bottom keeps it visibly lit through the
    whole breath so the perceived fade is smooth. Lower peak softens the
    top so it doesn't feel harsh in a dark room.
    Also gitignore build_prod/ (was missing alongside build_hil/).
    [led.c]
2026-08-14 feat(led): TIMER13-driven PWM + gamma breath curve + unified brightness cap
    Replace main-loop-driven software PWM with a dedicated TIMER13 @ 10 kHz
    (0.1 ms tick). The previous implementation ran from SysTick at 1 kHz,
    which capped duty resolution at 10 levels per 10 ms carrier — the breath
    curve visibly stepped through 4-5 brightness levels on the down-slope.
    Architecture:
    - TIMER13 (basic timer) configured for 10 kHz update IRQ, priority 3
    (lowest, after EXTI/SysTick). Decoupled from SysTick so the millisecond
    time base used everywhere else is unchanged.
    - led_pwm_tick() called from TIMER13_IRQHandler; advances a 0..99 sub-tick
    counter and re-applies BREATH/BLINK/ON LEDs against th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
    [hal_timer.c, led.c, led.h]
2026-08-14 feat(hil): CHG_DIAG wireless-charge diagnostic command + timeline script
    New HIL opcode 0x3017 returns an 11-byte raw snapshot of the wireless
    charge bring-up chain, polled by _chg_diag.py to build a timeline of
    what happens when a case is placed on the Qi pad:
    [0] flags — PA11/PA12/PB11 live levels + mt5706_is_enabled
    [1] ok — per-register I2C read success bitmap
    [2..4] — IP5353 SYS_STATE0/2/5 raw (input validity, charge enable,
    chg_state incl. timeout(6) and delayed-charge(7))
    [10] — IP5353 NTC_STATE (0x6F) raw
    [5..9] — CW2017 VCELL(2B)/SOC/VERSION/CONFIG raw
    All reads go through hal_i2c_read_reg directly — bypassing
    ip5353_ensure_r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
2026-08-14 build: restrict -Os to HIL build, production stays -O0
    -Os has not been qualified on production firmware (no full timing/power
    regression has been run against an -Os image), so revert the production
    build to the toolchain default. The HIL build keeps -Os: it needs the
    space (update_mode + diagnostics overflow the 27 KB app partition at
    -O0) and that image has been field-validated with -Os during the
    wireless-charge diagnosis session on real hardware.
    prod text: 26984 B (-O0, unchanged from pre--Os)
    HIL text: 13624 B (-Os, fits with diagnostics)
2026-08-14 feat(protocol): switch AT frame to all-little-endian + Size=payload length
    Align the frame format with the glasses-side protocol implementation
    (confirmed by a real-capture frame: 23 54 41 23 .. 04 00 .. 01 30 ..):
    - Magic/Size/Opcode packed little-endian. Magic constants keep their
    numeric values (0x23415423 / 0x23415023) — the LE packing alone
    changes the wire bytes to 23 54 41 23 ("#TA#") / 23 50 41 23.
    - Size now carries the PAYLOAD length only; a frame occupies
    Size + 10 bytes on the wire. Previously Size held the total frame
    length. pack/parse/recv in at_frame.c, the HIL header sniffing in
    update_mode.c, and sgc_at.py (pack/parse/recv_request) all updated.
    - OTA payload mu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
2026-08-14 test: align suites with LE protocol + reset version to 1
    - CASE_FW_VERSION 0x0C -> 0x01: new test baseline starts from version 1.
    - test_protocol.c: magic byte expectations now 23 54 41 23 / 23 50 41 23
    (LE packing of the unchanged constants).
    - HIL suites (a/c/i): opcode/size field reads swapped ">H" -> "<H";
    A03 asserts size+10 == frame length and size == 4 (payload semantics).
    - mock_stubs: add hal_usart_rx_avail stub (added with the 512B RX buffer
    rework; host link was missing it).
    - CONTEXT.md: I-class marked PASS 2026-08-14 — I01 8s / I02 20.7s under
    the new all-LE protocol, first full-chain validation; post-burn
    heartbeat frame byte-identical to the glasses real-capture fo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
    [fw_version.h, mock_stubs.c, test_a_protocol.py, test_c_state_machine.py, test_i_ota.py, test_protocol.c]
2026-08-19 docs(cw2017): flag profile as unverified demo default, not cell spec
    The comment claimed "Battery profile for 4.2V Li-ion 2000mAh" as if it
    were the product's battery spec. It is the Cellwise CW2017 Driver V1.4.1
    demo default; the product requirement only specifies "Li-ion 2000mAh
    2C" and defines NO charge termination voltage. Reword the profile
    header and the two CONTEXT.md mentions to state the origin and the
    risk plainly: if the real cell is a 4.35V system the SOC% computed
    from this curve is wrong. Includes the open-circuit-voltage check to
    identify the actual cell system (4.2V rests ~4.16-4.20V full; 4.35V
    rests ~4.30-4.35V full).
    [cw2017.c]
2026-08-19 fix(boot): force LEDs off at bootloader entry, kill init glitch
    After POR every GPIO floats and the active-low LED bank glows faintly -
    seen as the brief red/blue flash on plug-in. Nail RED/GREEN/2812/BLUE/
    WHITE to push-pull HIGH in the first instructions of BL (raw register
    writes: SPL gpio/rcu would cost >1KB of the 4KB slot). Also covers the
    ~3s OTA staging copy, during which the LEDs previously floated too.
    App side: hal_gpio_init now writes ODR before the input->output mode
    switch, so the pins never drive the ODR reset value (0 = LED on) for a
    glitch. Remaining undefined window is the tens of us between POR and
    BL main - invisible.
    [hal_gpio.c, main.c]
2026-09-04 fix(protocol): CRC8 excludes magic — covers only bytes after the CRC byte
    Real-glasses captures show both a HEART RSP (wire CRC 0x25) and a CRC-error
    NAK (0x52) verify only when CRC spans Size..payload (no magic). The old
    magic-inclusive span made every exchange fail: glasses NAKed 0x06 forever and
    the case rejected every RSP, so handshake could never succeed on real hardware
    (HIL passed because the PC simulator used the same wrong span).
    [at_frame.c]
2026-09-04 test(hil): align PC-side frame_crc with glasses CRC span (no magic)
    Mirrors firmware fix 99e1637: CRC8 covers only bytes after the CRC byte.
    Verified against three real-glasses captures (REQ 0x9D, RSP 0xD2, NAK 0x52).
    Also fixes the A05 docstring; its assertions were span-agnostic and pass.
    [sgc_at.py, test_a_protocol.py]
